nurdamiron/rams-projects/firmware/PRODUCTION_v3.2_FINAL/README.md

# RAMS Production Firmware v3.2 FINAL

**Дата:** 2026-02-15
**Статус:** ✅ ПРОТЕСТИРОВАНО И ПРОШИТО
**Автор:** RAMS Global Team

---

## 📦 Состав папки

```
PRODUCTION_v3.2_FINAL/
├── esp32/
│   ├── rams_controller_v3.ino    - ESP32 главный контроллер
│   └── ACTUATOR_CONFIG.h         - Конфигурация блоков
├── mega1/
│   ├── actuator_mega1_v3.ino     - Arduino Mega #1 (блоки 1-8)
│   └── ACTUATOR_CONFIG.h         - Конфигурация блоков
├── mega2/
│   └── actuator_mega2_v3.ino     - Arduino Mega #2 (блоки 9-15)
├── shared/
│   └── ACTUATOR_CONFIG.h         - Общая конфигурация
└── README.md                      - Этот файл
```

---

## 🎯 Назначение устройств

### ESP32 (rams_controller_v3.ino)
- **Функция:** Главный контроллер системы
- **Управление:** 15 актуаторных блоков + LED зоны
- **WiFi AP:** RAMS_Controller (пароль: rams2026)
- **Web интерфейс:** http://192.168.4.1
- **Serial порты:**
  - Serial1 (GPIO25 TX, GPIO26 RX) → Mega #1
  - Serial2 (GPIO16 TX, GPIO17 RX) → Mega #2
- **LED пины:** GPIO 21,22,23,15,13,27,32,33,5,2 (10 лент)
- **Размер:** 847 KB (64% flash)

### Arduino Mega #1 (actuator_mega1_v3.ino)
- **Функция:** Управление блоками 1-8
- **Актуаторы:** 16 штук (8 блоков × 2 актуатора)
- **Serial порт:** Serial1 (TX1/RX1 pins 18/19) → ESP32
- **Пины:** 22-53 (см. ACTUATOR_CONFIG.h)
- **Размер:** 8932 bytes (3% flash)

### Arduino Mega #2 (actuator_mega2_v3.ino)
- **Функция:** Управление блоками 9-15
- **Актуаторы:** 15 штук (6 блоков × 2 + блок 15 × 3)
- **Serial порт:** Serial1 (TX1/RX1 pins 18/19) → ESP32
- **Пины:** 22-53 (см. ACTUATOR_CONFIG.h)
- **Особенность:** Блок 15 имеет 3 актуатора!

---

## 🔌 LED Маппинг (ESP32)

### Физическая конфигурация:
- **8 лучей:** 33 LED каждый (GPIO 21,22,23,15,13,27,32,33)
- **Внутренний круг:** 64 LED (GPIO 5)
- **Внешний круг:** 150 LED (GPIO 2)

### Логика блоков:

**ВНЕШНИЕ блоки (1,3,5,7,9,11,13):**
- Внешняя часть лучей (LED 18-32)
- Внешний круг

**ВНУТРЕННИЕ блоки (2,4,6,8,10,12,14):**
- Внутренняя часть лучей (LED 0-17)
- Внутренний круг

**Блок 15 (особый):**
- ПОЛНЫЙ луч (LED 0-32)
- Внутренний круг
- БЕЗ внешнего круга

### Деление на доли:
```
Блоки 1-2   → Доля 0 (лучи GPIO21-22)
Блоки 3-4   → Доля 1 (лучи GPIO22-23)
Блоки 5-6   → Доля 2 (лучи GPIO23-15)
Блоки 7-8   → Доля 3 (лучи GPIO15-13)
Блоки 9-10  → Доля 4 (лучи GPIO13-27)
Блоки 11-12 → Доля 5 (лучи GPIO27-32)
Блоки 13-14 → Доля 6 (лучи GPIO32-33)
Блок 15     → Доля 7 (лучи GPIO33-21)
```

---

## 📡 Протокол связи (текстовый)

### Формат команд (ESP32 → Mega):
```
BLOCK:5:UP:10000    - Блок 5 вверх на 10 сек
BLOCK:3:DOWN:5000   - Блок 3 вниз на 5 сек
BLOCK:7:STOP        - Остановить блок 7
ALL:STOP            - Остановить все блоки
PING                - Проверка связи
```

### Ответы (Mega → ESP32):
```
ACK:5:UP            - Подтверждение команды
DONE:5              - Блок завершил работу
PONG                - Ответ на пинг
ERROR:message       - Ошибка
```

### Технические параметры:
- **Baud rate:** 115200
- **Формат:** 8N1
- **Heartbeat:** каждые 2 секунды
- **Timeout:** автоматическая остановка после времени

---

## 🔧 Инструкция по прошивке

### ESP32:
```bash
cd esp32/
arduino-cli compile --fqbn esp32:esp32:esp32 rams_controller_v3.ino
arduino-cli upload -p /dev/cu.usbserial-0001 --fqbn esp32:esp32:esp32 rams_controller_v3.ino
```

### Arduino Mega #1:
```bash
cd mega1/
arduino-cli compile --fqbn arduino:avr:mega actuator_mega1_v3.ino
arduino-cli upload -p /dev/cu.usbmodem141021 --fqbn arduino:avr:mega actuator_mega1_v3.ino
```

### Arduino Mega #2:
```bash
cd mega2/
# Сначала скопировать ACTUATOR_CONFIG.h из shared/
cp ../shared/ACTUATOR_CONFIG.h .
# Изменить include в .ino файле на: #include "ACTUATOR_CONFIG.h"
arduino-cli compile --fqbn arduino:avr:mega actuator_mega2_v3.ino
arduino-cli upload -p /dev/cu.usbserial-XXXX --fqbn arduino:avr:mega actuator_mega2_v3.ino
```

---

## 🎮 Web API (ESP32)

### Endpoints:

**GET /** - Главная страница с управлением

**GET /api/status** - Статус системы
```json
{
  "active": 2,
  "blocks": [1, 5]
}
```

**POST /api/block** - Управление блоком
```
?num=5&action=UP&duration=10000
```

**POST /api/stop** - Остановить все блоки

---

## ⚙️ Конфигурация пинов (ACTUATOR_CONFIG.h)

### Блок 1-8 (Mega #1):
| Блок | Акт.1 UP | Акт.1 DOWN | Акт.2 UP | Акт.2 DOWN |
|---|---|---|---|---|
| 1 | 22 | 23 | 24 | 25 |
| 2 | 26 | 27 | 28 | 29 |
| 3 | 30 | 31 | 32 | 33 |
| 4 | 34 | 35 | 36 | 37 |
| 5 | 38 | 39 | 40 | 41 |
| 6 | 50 | 51 | 52 | 53 |
| 7 | 42 | 43 | 44 | 45 |
| 8 | 46 | 47 | 48 | 49 |

### Блок 9-15 (Mega #2):
| Блок | Акт.1 UP | Акт.1 DOWN | Акт.2 UP | Акт.2 DOWN | Акт.3 UP | Акт.3 DOWN |
|---|---|---|---|---|---|---|
| 9 | 22 | 23 | 24 | 25 | - | - |
| 10 | 26 | 27 | 28 | 29 | - | - |
| 11 | 30 | 31 | 32 | 33 | - | - |
| 12 | 34 | 35 | 36 | 37 | - | - |
| 13 | 38 | 39 | 40 | 41 | - | - |
| 14 | 50 | 51 | 52 | 53 | - | - |
| 15 | 42 | 43 | 44 | 45 | 46 | 47 |

### Логика реле:
- **RELAY_ON = LOW** (инверсная логика!)
- **RELAY_OFF = HIGH**

---

## ✅ История изменений

### v3.2 (2026-02-15) - FINAL
- ✅ Правильный LED маппинг для всех 15 блоков
- ✅ OUTER блоки (1,3,5,7,9,11,13,15): внешняя часть + внешний круг
- ✅ INNER блоки (2,4,6,8,10,12,14): внутренняя часть + внутренний круг
- ✅ Блок 15: полный луч + внутренний круг, БЕЗ внешнего
- ✅ DroneControl style код (все в loop, без лишних функций)
- ✅ Текстовый протокол (быстрый sscanf парсинг)
- ✅ Централизованная конфигурация ACTUATOR_CONFIG.h
- ✅ Успешно прошито и протестировано

---

## 🚀 Быстрый старт

1. Прошить все 3 устройства (см. инструкцию выше)
2. Подключить Serial кабели: ESP32 ↔ Mega #1, ESP32 ↔ Mega #2
3. Подключить LED ленты к ESP32 (GPIO 21,22,23,15,13,27,32,33,5,2)
4. Подключить актуаторы к Mega платам (см. таблицу пинов)
5. Подключиться к WiFi "RAMS_Controller" (пароль: rams2026)
6. Открыть http://192.168.4.1
7. Тестировать блоки через веб-интерфейс

---

## 📝 Примечания

- Максимум 2 активных блока одновременно (защита от перегрузки)
- Автоматический timeout для всех операций
- Heartbeat проверка связи каждые 2 секунды
- Все настройки в одном файле ACTUATOR_CONFIG.h

---

**🎉 PRODUCTION READY!**
