nurdamiron/rams-projects/firmware/arduino_mega/README.md

# Arduino Mega - Actuator Controller

## 📋 Обзор

**ДВЕ ARDUINO MEGA** для управления 15 блоками актуаторов (31 актуатор)

- **Mega #1**: Блоки 1-8 (16 актуаторов)
- **Mega #2**: Блоки 9-15 (15 актуаторов, блок 15 имеет 3 актуатора)

Обе платы получают команды от ESP32 по Serial1.

---

## 🔌 MEGA #1 - Блоки 1-8

### Конфигурация (16 актуаторов, 32 пина)

| Блок | Пины | Актуаторы |
|---|---|---|
| 1 | 22, 23, 24, 25| 2 |
| 2 | 26, 27, 28, 29| 2 |
| 3 | 30, 31, 32, 33| 2 |
| 4 | 34, 35, 36, 37| 2 |
| 5 | 38, 39, 40, 41| 2 |
| 6 | 50, 51, 52, 53| 2 (физически запаян)|
| 7 | 42, 43, 44, 45| 2 |
| 8 | 46, 47, 48, 49| 2 |

**Прошивка:** `actuator_mega1/actuator_mega1.ino`

---

## 🔌 MEGA #2 - Блоки 9-15

### Конфигурация (15 актуаторов, 30 пинов)

| Блок | Пины | Актуаторы |
|---|---|---|
| 9 | 22, 23, 24, 25 | 2 |
| 10 | 26, 27, 28, 29 | 2 |
| 11 | 30, 31, 32, 33 | 2 |
| 12 | 34, 35, 36, 37 | 2 |
| 13 | 38, 39, 40, 41 | 2 |
| 14 | 50, 51, 52, 53 | 2 (физически запаян)|
| 15 | 42, 43, 44, 45, 46, 47 | **3** |

**ВАЖНО:** Блок 15 использует **6 пинов** для 3-х актуаторов!

**Прошивка:** `actuator_mega2/actuator_mega2.ino`

---

## 🔧 Логика работы

### Инверсная логика
- **LOW (0V)** = Актуатор включен
- **HIGH (5V)** = Актуатор выключен

### Управление одним актуатором
Каждый актуатор использует 2 пина:
- **Pin A = LOW, Pin B = HIGH** → Движение ВВЕРХ
- **Pin A = HIGH, Pin B = LOW** → Движение ВНИЗ
- **Pin A = HIGH, Pin B = HIGH** → СТОП

---

## 📡 Протокол связи

### Serial1 (TX1=18, RX1=19) ↔ ESP32

**Формат команды (JSON):**
```json
{"block":1,"action":"up","duration":12000}
{"block":9,"action":"down","duration":12000}
{"block":15,"action":"up","duration":12000}
{"block":0,"action":"stop"}
```

**Параметры:**
- `block` - номер блока:
  - Mega #1: 1-8
  - Mega #2: 9-15
  - 0 = остановить все блоки на текущей плате
- `action` - действие: "up", "down", "stop"
- `duration` - время движения в миллисекундах (по умолчанию 12000)

**Формат ответа:**
```json
{"status":"ok","block":1,"action":"up"}
{"status":"error","message":"Invalid command"}
{"status":"stopped","block":1,"reason":"timeout"}
{"status":"ready","mega":1,"blocks":8}
{"status":"ready","mega":2,"blocks":7}
```

---

## 🚀 Загрузка прошивки

### Mega #1 (Блоки 1-8)

1. **Подключи Mega #1 к USB**
2. **Открой Arduino IDE**
3. **Открой файл:** `actuator_mega1/actuator_mega1.ino`
4. **Установи библиотеку:** ArduinoJson
   - Tools → Manage Libraries → Найти "ArduinoJson" → Install
5. **Выбери настройки:**
   - Tools → Board → **Arduino Mega or Mega 2560**
   - Tools → Port → **(выбери COM порт)**
6. **Upload (Ctrl+U)**

### Mega #2 (Блоки 9-15)

1. **Подключи Mega #2 к USB**
2. **Открой Arduino IDE**
3. **Открой файл:** `actuator_mega2/actuator_mega2.ino`
4. **Установи библиотеку:** ArduinoJson (если еще не установлена)
5. **Выбери настройки:**
   - Tools → Board → **Arduino Mega or Mega 2560**
   - Tools → Port → **(выбери COM порт)**
6. **Upload (Ctrl+U)**

---

## 🧪 Тестирование

### Тест Mega #1 (через Serial Monitor, 115200 baud)

```json
{"block":1,"action":"up","duration":5000}
{"block":8,"action":"down","duration":5000}
```

**Вывод:**
```
[BLOCK 1] → UP (5000ms, 2 actuators)
[AUTO-STOP] Block 1
```

### Тест Mega #2 (через Serial Monitor, 115200 baud)

```json
{"block":9,"action":"up","duration":5000}
{"block":15,"action":"up","duration":5000}
```

**Вывод:**
```
[BLOCK 9] → UP (5000ms, 2 actuators)
[BLOCK 15] → UP (5000ms, 3 actuators)
[AUTO-STOP] Block 15
```

---

## ⚙️ Особенности

### ✅ Автоостановка
- Каждый блок автоматически останавливается после `duration` миллисекунд
- Безопасность: актуаторы не будут работать бесконечно

### ✅ Независимое управление
- Каждая Mega работает независимо
- Можно управлять несколькими блоками одновременно на одной плате
- Каждый блок имеет независимый таймер

### ✅ Обработка ошибок
- Проверка валидности JSON
- Проверка диапазона блоков
- Mega #1: блоки 1-8
- Mega #2: блоки 9-15
- Отправка статуса выполнения ESP32

---

## 🔌 Подключение к ESP32

```
Arduino Mega #1        ESP32
─────────────────────────────
TX1 (Pin 18) ────────► GPIO 16 (RX2)
RX1 (Pin 19) ◄──────── GPIO 17 (TX2)
GND ──────────────────── GND

Arduino Mega #2        ESP32
─────────────────────────────
TX1 (Pin 18) ────────► GPIO 26 (RX1)
RX1 (Pin 19) ◄──────── GPIO 25 (TX1)
GND ──────────────────── GND
```

**ESP32 использует:**
- **Serial2** (GPIO 16/17) для Mega #1
- **Serial1** (GPIO 25/26) для Mega #2

---

## 📊 Статистика

### Mega #1
- **Блоки:** 8
- **Актуаторы:** 16 (все стандартные по 2)
- **Пины:** 32 (22-53)
- **Baud rate:** 115200
- **Время по умолчанию:** 12000 мс (12 секунд)

### Mega #2
- **Блоки:** 7
- **Актуаторы:** 15 (6×2 + 1×3)
- **Пины:** 30 (22-47, 50-53)
- **Baud rate:** 115200
- **Время по умолчанию:** 12000 мс (12 секунд)

### Итого
- **Всего блоков:** 15
- **Всего актуаторов:** 31
- **Две Arduino Mega 2560**

---

## 📝 Примечания

1. **Не используй пины 0 и 1** - они зарезервированы для Serial (USB)
2. **Пины 18 и 19** используются для Serial1 (связь с ESP32)
3. **Блок 6 на Mega #1** и **Блок 14 на Mega #2** физически запаяны на пины 50-53
4. **Блок 15** имеет 3 актуатора (пины 42-47)
5. **Пины 48-49** не используются на Mega #2

---

## ⚠️ Важно

- **Mega #1** отвечает только за блоки 1-8
- **Mega #2** отвечает только за блоки 9-15
- Команды с неправильным номером блока будут отклонены
- ESP32 должен знать, на какую Mega отправлять команду для каждого блока
- Блок 15 имеет **3 актуатора** (6 пинов: 42, 43, 44, 45, 46, 47)

---

**Версия:** 2.0 (две независимые Mega)
**Дата:** 2026-02-09
