nurdamiron/rams-projects/docs/HARDWARE-ARCHITECTURE.md

# Архитектура управления хардвером RAMS Interactive Hub

## Обзор системы

Система управления хардвером для интерактивных макетов недвижимости RAMS Global. Управление освещением проектов (WS2812B LED), актуаторами (подъемники, крыши) и другими элементами через ESP32 по WiFi.

---

## Компоненты системы

### 1. **Electron/Next.js приложение** (Frontend/Backend)
- **Роль**: Интерфейс управления, отправка команд на ESP32
- **Технологии**: Next.js, React, Electron, SerialPort, WiFi HTTP
- **Расположение**: `/lib/hardware/wifi.ts`, `/lib/hardware/serial.ts`

### 2. **ESP32 микроконтроллер**
- **Роль**: Центральный контроллер хардвера
- **Функции**:
  - Получение команд по WiFi (HTTP Server)
  - Управление WS2812B LED лентами
  - Управление реле для 12В актуаторов
  - Обработка состояний и эффектов
- **WiFi**: Access Point или Station mode
- **IP**: Статический (по умолчанию 192.168.1.100)

### 3. **WS2812B адресные LED ленты**
- **Роль**: Подсветка макетов проектов
- **Характеристики**:
  - Напряжение: 5V
  - Тип данных: 1-wire protocol
  - Управление: FastLED библиотека
- **Подключение**: GPIO pin → Data line

### 4. **Реле модули** (для 12В нагрузки)
- **Роль**: Коммутация мощных 12В устройств
- **Типы**:
  - Одноканальные реле (освещение)
  - Двухканальные реле (актуаторы вверх/вниз)
- **Подключение**: GPIO → Relay IN pin

### 5. **12В Актуаторы** (Linear Actuators)
- **Роль**: Механическое перемещение элементов макета (крыши, лифты)
- **Управление**: H-Bridge или реле для изменения полярности
- **Питание**: Внешний 12В источник питания

---

## Архитектура коммуникации

```
┌─────────────────────────────────────────┐
│   Electron + Next.js Application       │
│   (Windows/Mac)                        │
│                                        │
│   WiFiHardwareService                  │
│   - sendCommand()                       │
│   - ping()                              │
└───────────────┬────────────────────────┘
                │
                │ HTTP POST /command
                │ WiFi (192.168.1.x)
                │
┌───────────────▼────────────────────────┐
│           ESP32                        │
│   Web Server (AsyncWebServer)          │
│   - Handle /command endpoint           │
│   - Parse JSON commands                │
│   - Route to hardware controllers      │
│                                        │
│   ┌─────────────────────────────────┐ │
│   │  LED Controller (FastLED)       │ │
│   │  - Project lighting effects     │ │
│   │  - Animations (fade, pulse)     │ │
│   └───────────┬─────────────────────┘ │
│               │                        │
│   ┌───────────▼─────────────────────┐ │
│   │  Relay Controller               │ │
│   │  - On/Off control               │ │
│   └───────────┬─────────────────────┘ │
│               │                        │
│   ┌───────────▼─────────────────────┐ │
│   │  Actuator Controller            │ │
│   │  - Up/Down movement             │ │
│   │  - Position tracking            │ │
│   └───────────┬─────────────────────┘ │
└───────────────┼────────────────────────┘
                │
    ┌───────────┼───────────┬──────────┐
    │           │           │          │
┌───▼───┐  ┌───▼───┐  ┌───▼────┐ ┌──▼──┐
│WS2812B│  │ Relay │  │Actuator│ │Relay│
│Strip 1│  │ #1    │  │  12V   │ │ #2  │
└───────┘  └───────┘  └────────┘ └─────┘
```

---

## Протокол команд

### Структура команды (JSON)

```typescript
interface HardwareCommand {
  action: 'select_project' | 'reset' | 'screensaver' |
          'toggle_element' | 'highlight' | 'off' | 'actuator';
  projectId?: number;        // ID проекта (0-27)
  target?: string;           // Целевой элемент (light, roof, landscape)
  state?: 'up' | 'down' | boolean;  // Состояние
  data?: {
    brightness?: number;     // Яркость (0-255)
    color?: string;          // Hex цвет (#FF0000)
    effect?: string;         // Эффект (fade, pulse, rainbow)
    duration?: number;       // Длительность в мс
  };
}
```

### Примеры команд

#### 1. Подсветить проект
```json
{
  "action": "highlight",
  "projectId": 9,
  "data": {
    "brightness": 200,
    "color": "#FFD700",
    "effect": "fade"
  }
}
```

#### 2. Управление актуатором
```json
{
  "action": "actuator",
  "target": "roof",
  "state": "up"
}
```

#### 3. Сброс всего
```json
{
  "action": "reset"
}
```

---

## Конфигурация проектов

Каждый проект имеет `hardwareId` для связи с физическим макетом:

```typescript
// lib/data/projects.ts
export interface Project {
  id: string;
  name: string;
  hardwareId?: number;  // Физический ID на контроллере (0-27)
  // ...
}
```

### Маппинг проектов на хардвер

| projectId | Название проекта | LED Start | LED Count | Реле | Актуатор |
|---|---|---|---|---|---|
| 0 | RAMS BEYOND | 0 | 50 | - | - |
| 1 | RAMS CITY | 50 | 30 | 1 | - |
| 2 | NOMAD | 80 | 20 | - | - |
| 9 | RAMS GARDEN | 200 | 60 | 2 | 1 |
| 11 | RAMS SIGNATURE | 300 | 50 | 3 | 2 |
| ... | ... | ... | ... | ...  | ... |

---

## Состояния и логика

### 1. **Режимы работы**

#### Idle Mode (Ожидание)
- Все проекты выключены
- Screensaver может быть активен (плавная анимация)

#### Project Highlight Mode
- Один проект подсвечен
- Остальные затемнены или выключены
- Возможные эффекты: fade in, pulse, rainbow

#### Demo Mode (Screensaver)
- Циклическая подсветка проектов
- Rainbow или wave эффект по всем LED

### 2. **Debouncing и очередь команд**

Реализовано в `WiFiHardwareService`:
- Команды дебаунсятся на 150ms
- При быстром переключении отменяется предыдущая команда
- Команды актуаторов выполняются немедленно

---

## Технические спецификации

### ESP32 Pinout

| Функция | GPIO Pin | Тип | Примечание |
|---|---|---|---|
| WS2812B Data | GPIO 16  | Output  | 5V logic, level shifter |
| Relay 1 | GPIO 17  | Output  | Активный LOW |
| Relay 2 | GPIO 18  | Output  | Активный LOW |
| Relay 3 | GPIO 19  | Output  | Активный LOW |
| Actuator Up | GPIO 21  | Output  | Через H-Bridge или реле |
| Actuator Down | GPIO 22  | Output  | Через H-Bridge или реле |
| Status LED | GPIO 2 | Output  | Встроенный LED |
| Button (optional) | GPIO 0 | Input | Pullup, для тестирования |

### Питание

1. **ESP32**: 5V от USB или DC-DC converter
2. **WS2812B**: 5V, ток зависит от количества LED (50mA на LED при полной яркости)
   - 100 LED × 50mA = 5A @ 5V
   - **Рекомендуется**: Отдельный БП 5V/10A
3. **Реле**: 5V логика, коммутируют 12V нагрузку
4. **Актуаторы**: 12V, ток зависит от модели (обычно 2-5A)
   - **Рекомендуется**: Отдельный БП 12V/10A

### Безопасность

- **Оптоизоляция**: Реле модули имеют встроенную оптопару
- **Защита**: Диоды обратной полярности на актуаторах
- **Предохранители**: На каждой 12V линии
- **WiFi**: WPA2 шифрование, статический IP

---

## Библиотеки для ESP32

### Arduino IDE / PlatformIO

```ini
[platformio]
platform = espressif32
framework = arduino

[env:esp32dev]
board = esp32dev
lib_deps =
    fastled/FastLED @ ^3.6.0
    me-no-dev/ESPAsyncWebServer @ ^1.2.3
    me-no-dev/AsyncTCP @ ^1.1.1
    bblanchon/ArduinoJson @ ^6.21.0
```

### Ключевые библиотеки

1. **FastLED**: Управление WS2812B
2. **ESPAsyncWebServer**: HTTP сервер
3. **ArduinoJson**: Парсинг JSON команд
4. **WiFi**: Встроенная библиотека ESP32

---

## Эффекты и анимации

### Доступные эффекты

1. **Fade In/Out**: Плавное включение/выключение
2. **Pulse**: Пульсация яркости
3. **Rainbow**: Радужный эффект
4. **Wave**: Волна света
5. **Sparkle**: Мерцание
6. **Chase**: Бегущий огонь

### Реализация эффектов

```cpp
void fadeIn(int projectId, CRGB color, int duration) {
  int startLed = projects[projectId].ledStart;
  int count = projects[projectId].ledCount;

  for (int brightness = 0; brightness <= 255; brightness += 5) {
    for (int i = 0; i < count; i++) {
      leds[startLed + i] = color;
      leds[startLed + i].fadeLightBy(255 - brightness);
    }
    FastLED.show();
    delay(duration / 51);  // 51 steps (0-255 by 5)
  }
}
```

---

## Диагностика и отладка

### Индикация статуса

- **Встроенный LED (GPIO 2)**:
  - Быстрое мигание: Подключение к WiFi
  - Медленное мигание: Ожидание команд
  - Постоянно горит: Выполнение команды

### Serial Monitor

```cpp
Serial.begin(115200);
Serial.println("[INFO] ESP32 Hardware Controller Started");
Serial.print("[WIFI] IP Address: ");
Serial.println(WiFi.localIP());
```

### Логи на клиенте

```typescript
console.log('[Hardware WiFi] Command sent:', command.action);
console.warn('[Hardware WiFi] Hardware not available');
```

---

## Масштабируемость

### Для больших установок

1. **Множественные ESP32**:
   - Каждый ESP32 управляет своей группой проектов
   - Разные IP адреса (192.168.1.100, 192.168.1.101, ...)
   - Клиент рутит команды на нужный контроллер

2. **MQTT брокер** (опционально):
   - Централизованная система сообщений
   - Лучше для 10+ контроллеров
   - Pub/Sub архитектура

3. **Большие LED массивы**:
   - Параллельные линии (FastLED поддерживает до 8 параллельных)
   - Внешний драйвер питания для каждых 100-200 LED

---

## Troubleshooting

### ESP32 не отвечает

1. Проверить WiFi соединение
2. Ping ESP32: `ping 192.168.1.100`
3. Проверить Serial Monitor на ошибки
4. Перезагрузить ESP32

### LED не работают

1. Проверить питание 5V
2. Проверить Data line подключение
3. Уменьшить яркость (перегрев/недостаточный ток)
4. Добавить резистор 470Ω на Data line

### Актуаторы не двигаются

1. Проверить 12V питание
2. Проверить реле срабатывание (должен быть слышен щелчок)
3. Измерить напряжение на выходе реле
4. Проверить предохранители

### Команды выполняются медленно

1. Уменьшить COMMAND_DEBOUNCE_MS
2. Проверить WiFi сигнал
3. Оптимизировать эффекты (меньше delay)

---

## Следующие шаги

1. ✅ Архитектура определена
2. 🔄 Написание прошивки ESP32
3. 🔄 Схема подключения
4. 🔄 Конфигурация проектов
5. 🔄 Тестирование и калибровка

---

## Контакты

- **Документация**: `/docs/`
- **Исходники клиента**: `/lib/hardware/`
- **Firmware ESP32**: `/firmware/esp32/`

---

**Дата создания**: 2026-01-27
**Версия**: 1.0
**Автор**: RAMS Interactive Hub Team
