nurdamiron/rams-projects/firmware/ESP32-MEGA-COMMUNICATION.md

# 📡 ESP32 ↔ Arduino Mega Communication

## Архитектура системы

```
┌──────────────────────────────────────────────┐
│         Next.js Application                  │
│         (Touch Screen UI)                    │
└────────────────┬─────────────────────────────┘
                 │ WiFi HTTP
                 │ POST /command
                 ▼
┌──────────────────────────────────────────────┐
│              ESP32                           │
│      Master Controller v1.0                  │
│  • Принимает HTTP команды от Next.js         │
│  • Управляет LED WS2812B                     │
│  • Отправляет команды на Mega через Serial   │
└────────────┬─────────────────────────────────┘
             │ Serial UART (115200 baud)
             │ GPIO16(RX) ← TX1 Mega
             │ GPIO17(TX) → RX1 Mega
             ▼
┌──────────────────────────────────────────────┐
│         Arduino Mega #1                      │
│    Actuator Controller v1.0                  │
│  • Принимает JSON команды через Serial1      │
│  • Управляет 8 блоками (16 актуаторов)      │
│  • Автоостановка по таймеру                  │
│  • Отправляет подтверждения ESP32           │
└──────────────────────────────────────────────┘
```

---

## 🔌 Подключение

### Схема соединений

```
ESP32                    Arduino Mega
─────────────────────────────────────────
GPIO 17 (TX2) ────────► RX1 (Pin 19)
GPIO 16 (RX2) ◄──────── TX1 (Pin 18)
GND ──────────────────── GND
```

**ВАЖНО:**
- Общая земля (GND) обязательна!
- ESP32 работает на 3.3V, Mega на 5V
- Обычно совместимы напрямую, но для надёжности можно использовать level shifter

---

## 📋 Протокол связи

### Формат команды (ESP32 → Mega)

```json
{
  "block": 1,           // Номер блока (1-8), 0 = все блоки
  "action": "up",       // Действие: "up", "down", "stop"
  "duration": 12000     // Длительность движения (мс)
}
```

### Формат ответа (Mega → ESP32)

```json
{
  "status": "ok",       // Статус: "ok", "error", "stopped"
  "block": 1,           // Номер блока
  "action": "up",       // Выполненное действие
  "message": "..."      // Опциональное сообщение (при ошибке)
}
```

---

## 🎯 Примеры использования

### 1. Frontend → ESP32 (WiFi HTTP)

```typescript
// В Next.js приложении
import { hardwareService } from '@/lib/hardware-service';

// Поднять блок #1 на 12 секунд
await hardwareService.sendCommand({
  action: 'actuator',
  target: 'block_1',
  state: 'up',
  data: {
    duration: 12000
  }
});

// Опустить блок #3 на 10 секунд
await hardwareService.sendCommand({
  action: 'actuator',
  target: 'block_3',
  state: 'down',
  data: {
    duration: 10000
  }
});

// Остановить блок #5
await hardwareService.sendCommand({
  action: 'actuator',
  target: 'block_5',
  state: 'stop'
});

// Остановить ВСЕ блоки
await hardwareService.sendCommand({
  action: 'actuator',
  target: 'block_0',
  state: 'stop'
});
```

### 2. ESP32 → Arduino Mega (Serial)

```cpp
// В ESP32 коде (автоматически вызывается из executeCommand)
// Поднять блок #1
sendToMega(1, "up", 12000);

// Опустить блок #3
sendToMega(3, "down", 12000);

// Остановить блок #5
sendToMega(5, "stop", 0);

// Остановить все блоки
sendToMega(0, "stop", 0);
```

### 3. Прямая отправка команды на Mega (через Serial Monitor)

```json
{"block":1,"action":"up","duration":12000}
{"block":2,"action":"down","duration":10000}
{"block":5,"action":"stop"}
{"block":0,"action":"stop"}
```

---

## 🧪 Тестирование системы

### Шаг 1: Загрузка прошивок

#### Arduino Mega
```bash
cd /Users/nurdauletakhmatov/Desktop/rams-screen/rams-interactive-hub/firmware/arduino_mega/actuator_test
# Открыть actuator_test.ino в Arduino IDE
# Выбрать: Tools → Board → Arduino Mega
# Выбрать правильный COM порт
# Upload (Ctrl+U)
```

#### ESP32
```bash
cd /Users/nurdauletakhmatov/Desktop/rams-screen/rams-interactive-hub/firmware/esp32/rams_controller
# Открыть rams_controller.ino в Arduino IDE
# Выбрать: Tools → Board → ESP32 Dev Module
# Upload
```

### Шаг 2: Проверка Serial связи

1. **Подключить USB к Mega** → Открыть Serial Monitor (115200 baud)
   ```
   [READY] Waiting for commands from ESP32...
   ```

2. **Отправить тестовую команду** через Serial Monitor:
   ```json
   {"block":1,"action":"up","duration":5000}
   ```

3. **Проверить вывод:**
   ```
   [CMD] Received: {"block":1,"action":"up","duration":5000}
   [BLOCK 1] → UP (5000ms)
   ```

4. **Через 5 секунд:**
   ```
   [AUTO-STOP] Block 1
   ```

### Шаг 3: Проверка ESP32 → Mega

1. **Подключить ESP32 к WiFi**
   - Проверить IP: `http://192.168.1.100/status`

2. **Отправить команду через WiFi:**
   ```bash
   curl -X POST http://192.168.1.100/command \
     -H "Content-Type: application/json" \
     -d '{
       "action": "actuator",
       "target": "block_1",
       "state": "up",
       "data": {"duration": 5000}
     }'
   ```

3. **Проверить логи ESP32** (Serial Monitor):
   ```
   [CMD] Action: actuator | Target: block_1
   [MEGA] Sent: {"block":1,"action":"up","duration":5000}
   [MEGA] Response: {"status":"ok","block":1,"action":"up"}
   ```

4. **Проверить логи Mega**:
   ```
   [CMD] Received: {"block":1,"action":"up","duration":5000}
   [BLOCK 1] → UP (5000ms)
   [AUTO-STOP] Block 1
   ```

### Шаг 4: Проверка из Next.js приложения

```typescript
// В любом React компоненте
const handleBlockUp = async () => {
  const result = await hardwareService.sendCommand({
    action: 'actuator',
    target: 'block_1',
    state: 'up',
    data: { duration: 12000 }
  });

  console.log('Result:', result);
};
```

---

## 🔧 Troubleshooting

### Проблема: Mega не получает команды от ESP32

1. **Проверить подключение:**
   - ESP32 TX (GPIO17) → Mega RX1 (Pin 19)
   - ESP32 RX (GPIO16) → Mega TX1 (Pin 18)
   - Общая земля (GND)

2. **Проверить Serial Monitor Mega:**
   - Должно быть сообщение `[INIT] Serial1 ready for ESP32 commands`

3. **Проверить ESP32 Serial Monitor:**
   - Должно быть сообщение `[SETUP] Mega serial initialized on GPIO16(RX)/GPIO17(TX) ✓`

4. **Проверить baud rate:**
   - Оба должны быть 115200

### Проблема: Актуаторы не двигаются

1. **Проверить пины в Arduino Mega:**
   - Блок 1: пины 22, 23, 24, 25
   - Блок 2: пины 26, 27, 28, 29
   - и т.д.

2. **Проверить логику:**
   - ИНВЕРСНАЯ ЛОГИКА: LOW = включено, HIGH = выключено

3. **Проверить питание:**
   - Актуаторы требуют 12V
   - Достаточно ли ампер?

### Проблема: ESP32 не отправляет команды

1. **Проверить WiFi соединение:**
   ```bash
   curl http://192.168.1.100/ping
   ```

2. **Проверить формат target:**
   - Должен начинаться с `block_` (например `block_1`, `block_3`)

3. **Проверить Serial Monitor ESP32:**
   - Должны быть сообщения `[MEGA] Sent: ...`

---

## 📊 Маппинг блоков на пины

| Блок | Актуаторы | Pin 1 | Pin 2 | Pin 3 | Pin 4 |
|---|---|---|---|---|---|
| 1 | 2 шт | 22 | 23 | 24 | 25 |
| 2 | 2 шт | 26 | 27 | 28 | 29 |
| 3 | 2 шт | 30 | 31 | 32 | 33 |
| 4 | 2 шт | 34 | 35 | 36 | 37 |
| 5 | 2 шт | 38 | 39 | 40 | 41 |
| 6 | 2 шт | 50 | 51 | 52 | 53 |
| 7 | 2 шт | 42 | 43 | 44 | 45 |
| 8 | 2 шт | 46 | 47 | 48 | 49 |

**Логика управления одним блоком:**
- Pin 1 (LOW) + Pin 2 (HIGH) = Актуатор 1 ВВЕРХ
- Pin 1 (HIGH) + Pin 2 (LOW) = Актуатор 1 ВНИЗ
- Pin 3 (LOW) + Pin 4 (HIGH) = Актуатор 2 ВВЕРХ
- Pin 3 (HIGH) + Pin 4 (LOW) = Актуатор 2 ВНИЗ
- Все HIGH = СТОП

---

## 🚀 Готовые команды для тестирования

### Через curl (WiFi)

```bash
# Поднять блок 1 на 12 секунд
curl -X POST http://192.168.1.100/command \
  -H "Content-Type: application/json" \
  -d '{"action":"actuator","target":"block_1","state":"up","data":{"duration":12000}}'

# Опустить блок 3 на 10 секунд
curl -X POST http://192.168.1.100/command \
  -H "Content-Type: application/json" \
  -d '{"action":"actuator","target":"block_3","state":"down","data":{"duration":10000}}'

# Остановить блок 5
curl -X POST http://192.168.1.100/command \
  -H "Content-Type: application/json" \
  -d '{"action":"actuator","target":"block_5","state":"stop"}'

# Остановить ВСЕ блоки
curl -X POST http://192.168.1.100/command \
  -H "Content-Type: application/json" \
  -d '{"action":"actuator","target":"block_0","state":"stop"}'
```

### Через Serial Monitor Mega

```json
{"block":1,"action":"up","duration":12000}
{"block":2,"action":"down","duration":10000}
{"block":3,"action":"up","duration":8000}
{"block":0,"action":"stop"}
```

---

## 📝 Примечания

1. **Автоостановка**: Mega автоматически остановит актуаторы после `duration` миллисекунд
2. **Безопасность**: Если связь потеряна, Mega остановит актуаторы по таймеру
3. **Конкуренция**: Можно управлять несколькими блоками одновременно
4. **Логирование**: Все команды логируются в Serial Monitor для отладки

---

## 🎯 Следующие шаги

1. ✅ **Протестировать прямую связь Mega** (через Serial Monitor)
2. ✅ **Протестировать ESP32 → Mega** (через WiFi curl)
3. ✅ **Интегрировать в Next.js UI** (кнопки для управления блоками)
4. ⏳ **Добавить визуальные индикаторы** (показывать статус блоков)
5. ⏳ **Добавить датчики** (концевые выключатели для актуаторов)

---

**Документация обновлена:** 2026-02-08
**Версия:** 1.0
**Автор:** RAMS Global Team
