nurdamiron/rams-projects/firmware/esp32/README-START-HERE.md

# НАЧНИТЕ ОТСЮДА - RAMS Interactive Hub Hardware

## 📖 Быстрый старт

Добро пожаловать в систему управления хардвером для интерактивных макетов RAMS!

Этот гайд поможет вам подключить и настроить:
- ESP32 контроллер
- WS2812B LED ленты 12V
- Реле модули 5V/10A+
- Актуаторы 12V
- WiFi связь с Electron приложением

---

## 🎯 Что вы получите

После завершения установки:
- ✅ Интерактивный макет с подсветкой проектов
- ✅ Управление через WiFi (компьютер → ESP32)
- ✅ Эффекты: fade, pulse, rainbow, screensaver
- ✅ Управление дополнительным освещением через реле
- ✅ Управление движущимися элементами (актуаторы)

---

## 📚 Структура документации

Читать в следующем порядке:

### 1. **SHOPPING-LIST.md** - Что нужно купить
**Время**: 10 минут

- Полный список компонентов
- Где купить (AliExpress, Amazon, местные магазины)
- Примерная стоимость (~$100-200)
- Готовые наборы

👉 **Начните с этого файла**, чтобы заказать компоненты!

---

### 2. **WIRING-12V.md** - Подключение 12V оборудования
**Время**: 20 минут

- Детальные схемы подключения
- Особенности 12V WS2812B LED
- Level Shifter (3.3V → 5V)
- Питание и безопасность
- Реле и актуаторы

👉 **Прочитать перед подключением**, чтобы понять схему!

---

### 3. **LED-LAYOUT-GUIDE.md** - Схемы расположения LED
**Время**: 15 минут

- Круговой макет (радиальные секторы)
- Линейный макет (улицы/здания)
- Комбинированные схемы
- Как соединять LED ленты

👉 **Выберите схему** под ваш макет!

---

### 4. **PROJECT-CONFIG-EXAMPLE.h** - Конфигурация проектов
**Время**: 30 минут

- Пример маппинга проектов на хардвер
- Настройка GPIO пинов
- Настройка LED адресов
- Настройка реле и актуаторов

👉 **Скопируйте и адаптируйте** под ваши проекты!

---

### 5. **STEP-BY-STEP-INSTALL.md** - Пошаговая установка
**Время**: 3-5 часов

**ГЛАВНЫЙ ГАЙД!** Подробная инструкция:

- ШАГ 0: Проверка компонентов
- ШАГ 1: Подготовка ESP32
- ШАГ 2: Подключение первого LED (ТЕСТ)
- ШАГ 3: Подключение всех LED лент
- ШАГ 4: Подключение реле
- ШАГ 5: Подключение актуаторов
- ШАГ 6: Финальное тестирование

👉 **Следуйте этому гайду шаг за шагом!**

---

### 6. **HARDWARE-ARCHITECTURE.md** - Техническая архитектура
**Время**: 20 минут (опционально)

- Полная архитектура системы
- Протокол коммуникации
- API endpoints
- Эффекты и анимации
- Масштабируемость

👉 **Для понимания** как все работает изнутри.

---

### 7. **README.md** (ESP32 Firmware) - Документация прошивки
**Время**: 15 минут

- Установка Arduino IDE / PlatformIO
- Библиотеки
- API документация
- Troubleshooting
- Примеры команд

👉 **Справочник** по прошивке ESP32.

---

## 🚀 Быстрый путь (для опытных)

Если у вас уже есть опыт с ESP32 и LED лентами:

1. ✅ Купить компоненты из `SHOPPING-LIST.md`
2. ✅ Загрузить `rams_controller.ino` на ESP32
3. ✅ Подключить по схеме из `WIRING-12V.md`
4. ✅ Настроить конфигурацию в `PROJECT-CONFIG-EXAMPLE.h`
5. ✅ Протестировать через `curl` или браузер

---

## 📦 Что находится в этой папке

```
firmware/esp32/
│
├── README-START-HERE.md          ← ВЫ ЗДЕСЬ!
│
├── SHOPPING-LIST.md               ← Что купить
├── WIRING-12V.md                  ← Схемы подключения 12V
├── LED-LAYOUT-GUIDE.md            ← Схемы расположения LED
├── PROJECT-CONFIG-EXAMPLE.h       ← Пример конфигурации
├── STEP-BY-STEP-INSTALL.md        ← Пошаговая установка ⭐
│
├── rams_controller/               ← Прошивка ESP32
│   ├── rams_controller.ino        ← Основной файл
│   └── platformio.ini             ← Конфигурация PlatformIO
│
└── README.md                      ← Документация прошивки
```

---

## ⏱️ Сколько времени потребуется

### Фаза 1: Подготовка (1 день)
- Изучение документации: 2 часа
- Заказ компонентов: 30 минут
- Ожидание доставки: 1-4 недели

### Фаза 2: Установка (1 день)
- Подготовка ESP32: 1 час
- Тест первого LED: 30 минут
- Подключение всех LED: 2 часа
- Подключение реле и актуаторов: 1 час
- Тестирование: 1 час
- **ИТОГО**: ~5-6 часов

### Фаза 3: Калибровка (2-3 часа)
- Настройка яркости и цветов
- Проверка всех проектов
- Отладка проблем

**ОБЩЕЕ ВРЕМЯ**: 1-2 дня работы + время доставки компонентов

---

## 🛠️ Необходимые навыки

### Обязательно:
- ✅ Базовые знания электроники (напряжение, ток, полярность)
- ✅ Умение пользоваться мультиметром
- ✅ Умение подключать провода
- ✅ Базовые навыки работы с компьютером

### Полезно (но не обязательно):
- 🔧 Опыт с Arduino/ESP32
- 🔧 Навыки пайки
- 🔧 Программирование на C++

**Если нет опыта**: Не переживайте! Гайд написан максимально подробно, с картинками и пошаговыми инструкциями.

---

## ⚠️ Важные предупреждения

### Безопасность

1. **Электричество 220V**:
   - ⚡ ОПАСНО! Будьте осторожны с блоком питания
   - Подключайте к розетке только когда все собрано
   - Используйте БП с защитой от КЗ

2. **12V постоянный ток**:
   - ✅ Относительно безопасно
   - Но может быть БОЛЬШОЙ ТОК (10A+)
   - Избегайте короткого замыкания

3. **Полярность**:
   - ❌ Неправильная полярность = сгоревшие компоненты!
   - Всегда проверяйте: красный = +, черный = -

4. **Общая земля (GND)**:
   - ✅ КРИТИЧНО! Все GND должны быть соединены
   - ESP32 GND = БП 12V GND = общая земля

### Частые ошибки

- ❌ Забыли Level Shifter (LED не работают)
- ❌ Нет общей земли (LED мерцают или не работают)
- ❌ Неправильное направление Data line (LED не работают)
- ❌ Недостаточно мощный БП (LED тусклые)
- ❌ Неправильный тип LED (WS2811 vs WS2812B)

**Избежать**: Читайте документацию внимательно!

---

## 💡 Советы для успеха

### 1. Тестируйте поэтапно
- ✅ Не подключайте все сразу!
- ✅ Сначала ESP32
- ✅ Потом 1 метр LED
- ✅ Потом остальные LED
- ✅ Потом реле
- ✅ Потом актуаторы

### 2. Маркируйте провода
- Используйте цветную маркировку
- Наклеивайте бирки
- Делайте фото на каждом этапе

### 3. Измеряйте напряжение
- Проверяйте мультиметром перед включением
- +12V должно быть 11.8-12.3V
- 5V должно быть 4.8-5.2V

### 4. Делайте резервные копии
- Сохраните рабочую конфигурацию
- Сделайте фото проводки
- Запишите номера GPIO пинов

---

## 🆘 Помощь и поддержка

### Если что-то не работает:

1. **Проверьте Serial Monitor** ESP32:
   - Там будут логи и ошибки
   - 115200 baud rate

2. **Раздел Troubleshooting**:
   - `STEP-BY-STEP-INSTALL.md` → раздел "Troubleshooting"
   - `README.md` → раздел "Troubleshooting"

3. **Проверьте контакты**:
   - 90% проблем = плохой контакт
   - Перепроверьте все соединения

4. **Измерьте напряжение**:
   - Мультиметр - ваш лучший друг!

### Полезные ресурсы:

- **FastLED Wiki**: https://github.com/FastLED/FastLED/wiki
- **ESP32 Docs**: https://docs.espressif.com/
- **WS2812B Datasheet**: https://cdn-shop.adafruit.com/datasheets/WS2812B.pdf

---

## 📝 Чек-лист перед началом

Перед тем как начать, убедитесь что:

- [ ] Прочитали **SHOPPING-LIST.md**
- [ ] Заказали (или купили) все компоненты
- [ ] Прочитали **WIRING-12V.md** (поняли схему)
- [ ] Выбрали схему расположения LED из **LED-LAYOUT-GUIDE.md**
- [ ] Есть все инструменты (мультиметр, отвертки, кусачки)
- [ ] Есть 5-6 часов свободного времени для установки
- [ ] Готовы следовать **STEP-BY-STEP-INSTALL.md**

**Если все ✅ → Начинаем!**

---

## 🎉 После установки

Когда все заработает:

1. **Калибровка**:
   - Настроить яркость каждого проекта
   - Настроить цвета
   - Проверить эффекты

2. **Интеграция с приложением**:
   - Запустить Electron приложение
   - Проверить что команды работают
   - Настроить hardwareId в projects.ts

3. **Обучение персонала**:
   - Показать как включать/выключать
   - Объяснить базовые функции
   - Предупредить о правилах безопасности

4. **Обслуживание**:
   - Регулярно проверять контакты
   - Чистить от пыли
   - Проверять температуру компонентов

---

## 📧 Контакты

- **Проект**: RAMS Interactive Hub
- **GitHub**: https://github.com/rams-global
- **Email**: support@rams.global

---

## 📅 История версий

- **v1.0** (2026-01-27): Первый релиз документации
  - Полная архитектура
  - Прошивка ESP32
  - Пошаговые гайды
  - Поддержка 12V WS2812B

---

**Удачи с установкой! 🚀**

**Следующий шаг**: Откройте `SHOPPING-LIST.md` и начните с покупки компонентов!
