nurdamiron/rams-projects/firmware/PRODUCTION_v3.2_FINAL/PIN_MAPPING_REFERENCE.md

# RAMS ACTUATOR PIN MAPPING - ЭТАЛОННАЯ КОНФИГУРАЦИЯ

**Дата финализации:** 2026-03-04
**Версия прошивки:** v3.2_FINAL
**Статус:** ПРОТЕСТИРОВАНО И РАБОТАЕТ ✅

---

## ARDUINO MEGA #1 (Блоки 1-8)

| Блок | Актуаторы | Пины | Особенности |
|---|---|---|---|
| 1 | 2 | 22-25 | Стандарт |
| 2 | 2 | 26-29 | Стандарт |
| 3 | 2 | 30-33 | Стандарт |
| 4 | 2 | 34-37 | Стандарт |
| 5 | 2 | 38-41 | Стандарт |
| 6 | 2 | **50-53** | **Физически запаян** |
| 7 | 2 | 42-45 | Переназначен |
| 8 | 2 | 46-49 | Переназначен |

**Детальный маппинг Mega #1:**
- Блок 1: Act1(22↑,23↓) Act2(24↑,25↓)
- Блок 2: Act1(26↑,27↓) Act2(28↑,29↓)
- Блок 3: Act1(30↑,31↓) Act2(32↑,33↓)
- Блок 4: Act1(34↑,35↓) Act2(36↑,37↓)
- Блок 5: Act1(38↑,39↓) Act2(40↑,41↓)
- Блок 6: Act1(50↑,51↓) Act2(52↑,53↓) ⚠️ Физически запаян
- Блок 7: Act1(42↑,43↓) Act2(44↑,45↓)
- Блок 8: Act1(46↑,47↓) Act2(48↑,49↓)

---

## ARDUINO MEGA #2 (Блоки 9-15)

| Блок | Актуаторы | Пины | Особенности |
|---|---|---|---|
| 9 | 2 | 22-25 | Стандарт |
| 10 | 2 | 26-29 | Стандарт |
| 11 | 2 | **34-37** | **Поменян с блоком 12** ⚠️ |
| 12 | 2 | **30-33** | **Поменян с блоком 11** ⚠️ |
| 13 | 2 | 38-41 | Стандарт |
| 14 | 2 | 42-45 | Стандарт |
| 15 | **3** | **46-51** | **3 АКТУАТОРА, Act3 инвертирован** ⚠️ |

**Детальный маппинг Mega #2:**
- Блок 9:  Act1(22↑,23↓) Act2(24↑,25↓)
- Блок 10: Act1(26↑,27↓) Act2(28↑,29↓)
- Блок 11: Act1(34↑,35↓) Act2(36↑,37↓) ⚠️ Поменян с 12
- Блок 12: Act1(30↑,31↓) Act2(32↑,33↓) ⚠️ Поменян с 11
- Блок 13: Act1(38↑,39↓) Act2(40↑,41↓)
- Блок 14: Act1(42↑,43↓) Act2(44↑,45↓)
- Блок 15: Act1(46↑,47↓) Act2(48↑,49↓) Act3(51↑,50↓) ⚠️ Act3 инвертирован!

---

## КРИТИЧЕСКИЕ ОСОБЕННОСТИ

### 🔴 MEGA #2 - БЛОКИ 11 И 12 ПОМЕНЯНЫ МЕСТАМИ
Физическая проводка блоков 11 и 12 перепутана. В коде они исправлены:
- **Команда BLOCK:11** → физические пины 34-37
- **Команда BLOCK:12** → физические пины 30-33

### 🔴 MEGA #2 - БЛОК 15 АКТУАТОР 3 ИНВЕРТИРОВАН
Третий актуатор блока 15 (средний, ближе к центру) имеет обратную проводку:
- **Act3 UP:** пин 51 (не 50!)
- **Act3 DOWN:** пин 50 (не 51!)

### 🔴 ПИНЫ 52-53 НЕ ИСПОЛЬЗУЮТСЯ НА MEGA #2
На Mega #2 пины 52-53 **не подключены**. Используются только пины 22-51.

---

## ЛОГИКА РЕЛЕ

```cpp
#define RELAY_ON   LOW   // Инверсная логика: LOW = включено
#define RELAY_OFF  HIGH  // HIGH = выключено
```

Все реле используют **инверсную логику**:
- Для включения актуатора → устанавливаем пин в LOW
- Для выключения актуатора → устанавливаем пин в HIGH

---

## ПРОТОКОЛ СВЯЗИ

**Формат команды:**
```
BLOCK:<номер>:<действие>:<длительность_мс>
```

**Примеры:**
```
BLOCK:15:UP:6000      - Блок 15 вверх на 6 секунд
BLOCK:11:DOWN:10000   - Блок 11 вниз на 10 секунд
BLOCK:12:STOP         - Остановить блок 12
ALL:STOP              - Остановить все блоки
PING                  - Проверка связи
```

**Ответы:**
```
ACK:15:UP             - Подтверждение
DONE:15               - Блок завершил работу
PONG                  - Ответ на PING
ERROR:message         - Ошибка
```

---

## ФАЙЛЫ КОНФИГУРАЦИИ

**Единый источник истины:**
```
/firmware/PRODUCTION_v3.2_FINAL/shared/ACTUATOR_CONFIG.h
```

**Копии (автоматически синхронизируются):**
- `/firmware/PRODUCTION_v3.2_FINAL/actuator_mega1_v3/ACTUATOR_CONFIG.h`
- `/firmware/PRODUCTION_v3.2_FINAL/actuator_mega2_v3/ACTUATOR_CONFIG.h`
- `/firmware/PRODUCTION_v3.2_FINAL/esp32/rams_controller_v3/ACTUATOR_CONFIG.h`
- `/firmware/esp32/rams_controller_v3/ACTUATOR_CONFIG.h`

---

## ПРОШИВКИ

**Arduino Mega #1:**
```
/firmware/PRODUCTION_v3.2_FINAL/actuator_mega1_v3/actuator_mega1_v3.ino
```

**Arduino Mega #2:**
```
/firmware/PRODUCTION_v3.2_FINAL/actuator_mega2_v3/actuator_mega2_v3.ino
```

**ESP32 Master:**
```
/firmware/PRODUCTION_v3.2_FINAL/esp32/rams_controller_v3/rams_controller_v3.ino
```

---

## ИСТОРИЯ ИЗМЕНЕНИЙ

### 2026-03-04 - ФИНАЛЬНАЯ ВЕРСИЯ v3.2
- ✅ Исправлена инверсия актуатора 3 блока 15 (пины 51↑, 50↓)
- ✅ Поменяны местами блоки 11 и 12 (физическая проводка перепутана)
- ✅ Уточнено что пины 52-53 не используются на Mega #2
- ✅ Протестированы все 15 блоков
- ✅ Подтверждена корректная работа всех актуаторов

### Предыдущие проблемы (ИСПРАВЛЕНЫ):
- ❌ Блок 14: был на пинах 50-53 → исправлен на 42-45
- ❌ Блок 15: актуатор 3 был на пинах 50↑,51↓ → исправлен на 51↑,50↓
- ❌ Блоки 11-12: были на неправильных пинах → поменяны местами

---

## ТЕСТИРОВАНИЕ

**Протестировано:**
- ✅ Все 15 блоков отвечают на команды
- ✅ Направление движения UP/DOWN корректно
- ✅ Все актуаторы двигаются синхронно
- ✅ Блок 15 с 3 актуаторами работает правильно
- ✅ Таймауты и автоостановка работают
- ✅ Протокол связи стабилен

**Известные ограничения:**
- Максимум 2 блока одновременно (MAX_ACTIVE_BLOCKS = 2)
- Длительность по умолчанию: 6 секунд (DEFAULT_DURATION_MS = 6000)

---

## КОНТАКТЫ

**Проект:** RAMS Interactive Hub
**Команда:** RAMS Global Team
**Дата последнего обновления:** 2026-03-04

---

**⚠️ ВНИМАНИЕ:** Этот документ является эталонной конфигурацией. Любые изменения в маппинге пинов должны быть отражены здесь и протестированы на физическом оборудовании!
