nurdamiron/rams-projects/firmware/arduino_mega/ACTUATOR_7_PINS.md

# Actuator 7 - Вторая мега, 7 блок (последний)

## Пины
- PIN 50
- PIN 51

## Рабочая логика
**TEST 3: BOTH LOW (50=LOW, 51=LOW)** - РАБОТАЕТ! Актуатор движется

## Тесты которые НЕ работают
- TEST 1: PIN 50=LOW, PIN 51=HIGH - нет движения
- TEST 2: PIN 50=HIGH, PIN 51=LOW - нет движения
- TEST 4: BOTH HIGH - ???

## Примечание
Актуатор работает ТОЛЬКО когда оба пина установлены в LOW.
Нужно определить как разделить UP и DOWN направления.
