nurdamiron/rams-projects/firmware/PRODUCTION_v3.2_FINAL/esp32/README_UPGRADE.md

# ESP32 Firmware v3.2 - Upgrade Guide

## Что нового в этой версии

### ✅ НОВЫЕ ФИЧИ:
1. **8 LED эффектов** - Rainbow, Pulse, Chase, Sparkle, Wave, Fire, Meteor
2. **Плавное угасание LED** - LED постепенно тускнеет синхронно с опусканием актуатора (вместо резкого выключения)
3. **Управление яркостью** - через API `/api/bri` (0-255)
4. **Управление скоростью** - через API `/api/spd` (0-255)

### 🔧 КАК ПРОШИТЬ ESP32

#### Через Arduino IDE:

1. Откройте **Arduino IDE 2.x**

2. Установите плату ESP32:
   - Tools → Board Manager → поиск "ESP32"
   - Установите "esp32 by Espressif Systems"

3. Выберите плату:
   - Tools → Board → ESP32 Arduino → "ESP32 Dev Module"

4. Выберите порт:
   - Tools → Port → выберите `/dev/cu.usbserial-xxxx`
   - (На Windows: `COMxx`)

5. Откройте файл:
   - File → Open → выберите `rams_controller_v3.ino`

6. Откройте **все TAB-ы** (ACTUATOR_CONFIG.h должен быть открыт!)

7. Нажмите **Upload** (→ стрелка)

8. Дождитесь надписи:
   ```
   Hard resetting via RTS pin...
   ```

9. Откройте Serial Monitor (Tools → Serial Monitor):
   - Установите скорость: **115200 baud**
   - Проверьте вывод:
     ```
     ========================================
       RAMS CONTROLLER v3.2 PRODUCTION
       Actuators + LED Zones + Power Control
       DroneControl Style
     ========================================
     [LED] 10 strips initialized
     [WIFI] Connected to Rams_WIFI!
     [READY] System initialized!
     ```

### 📡 API ENDPOINTS

```bash
# Поднять блок 1 на 5 секунд
POST /api/block?num=1&action=UP&duration=5000

# Опустить блок 1 (с плавным fade LED)
POST /api/block?num=1&action=DOWN&duration=5000

# Остановить все блоки
POST /api/stop

# Установить цвет LED (RGB)
POST /api/color?r=255&g=100&b=0

# Установить яркость LED (0-255)
POST /api/bri?v=200

# Установить эффект (0=Static, 2=Rainbow, ...)
POST /api/effect?id=2&speed=128

# Установить скорость эффекта (0-255)
POST /api/spd?v=150
```

### 🌈 LED ЭФФЕКТЫ

| ID | Название  | Описание |
|----|---|---|
| 0  | Static | Статический цвет |
| 1  | Pulse | Пульсация (breathing) |
| 2  | Rainbow | Радуга (цикл HSV) |
| 3  | Chase | Бегущая точка с хвостом |
| 4  | Sparkle | Искры (случайные вспышки) |
| 5  | Wave | Волна (синусоида) |
| 6  | Fire | Огонь (heat simulation) |
| 7  | Meteor | Метеор (падающая звезда) |

### 🎨 ПЛАВНОЕ УГАСАНИЕ

При команде **DOWN** актуатор опускается, и LED **плавно тускнеет** за то же время:

```
t=0:      LED 100% яркость | Актуатор вверху
t=2.5s:   LED 50% яркость  | Актуатор в середине
t=5s:     LED 0% (выкл)    | Актуатор внизу
```

Синхронная анимация выглядит **плавно и профессионально** ✨

---

**Файл:** `rams_controller_v3.ino`
**Версия:** 3.2 (Production с LED эффектами + Fade)
**Дата:** 2026-02-16
**Автор:** RAMS Global Team
