nurdamiron/rams-projects/firmware/arduino_mega/actuator_mega2_PARTIAL_WORKING/README.md

# ЧАСТИЧНО РАБОЧАЯ ПРОШИВКА - Arduino Mega 2

**Дата:** 15 февраля 2026
**Статус:** ⚠️ ЧАСТИЧНО РАБОТАЕТ (Блоки 9-13)

## Описание

Управляет 7 блоками актуаторов (Blocks 9-15).
Блоки 9-13 работают ✅
Блоки 14-15 НЕ работают ❌ (нужно найти правильные пины)

## Рабочий маппинг пинов (Blocks 9-13)

### Блок 9 (пины 22-25) ✅
- Актуатор 1: UP = 22, DOWN = 23
- Актуатор 2: UP = 24, DOWN = 25

### Блок 10 (пины 26-29) ✅
- Актуатор 1: UP = 26, DOWN = 27
- Актуатор 2: UP = 28, DOWN = 29

### Блок 11 (пины 34-37) ✅ ИСПРАВЛЕНО!
- Актуатор 1: UP = 34, DOWN = 35
- Актуатор 2: UP = 36, DOWN = 37
- **Примечание:** Был перепутан с Block 12

### Блок 12 (пины 30-33) ✅ ИСПРАВЛЕНО!
- Актуатор 1: UP = 30, DOWN = 31
- Актуатор 2: UP = 32, DOWN = 33
- **Примечание:** Был перепутан с Block 11

### Блок 13 (пины 38-41) ✅
- Актуатор 1: UP = 38, DOWN = 39
- Актуатор 2: UP = 40, DOWN = 41

## НЕ работают (нужно найти пины!)

### Блок 14 ❌
- Текущие пины: 42,43,44,45
- **НЕ РАБОТАЕТ!** Нужно найти правильные пины

### Блок 15 ❌
- Текущие пины: 46,47,48,49
- **НЕ РАБОТАЕТ!** Нужно найти правильные пины
- **Важно:** Block 15 имеет 3 актуатора (не 2!)

## Логика реле

**ИНВЕРСНАЯ ЛОГИКА:**
- `LOW` = Реле ВКЛЮЧЕНО (актуатор работает)
- `HIGH` = Реле ВЫКЛЮЧЕНО (актуатор не работает)

## Важные замечания

### ⚠️ Блоки 11 и 12 перепутаны
Физическая проводка:
- Пины 30-33 → Block 12 (не Block 11!)
- Пины 34-37 → Block 11 (не Block 12!)

Это учтено в прошивке!

### ⚠️ Block 15 - 3 актуатора
Block 15 имеет 3 актуатора (не 2 как остальные):
- 2 актуатора на 4-канальном реле
- 1 актуатор на 2-канальном реле

## TODO

- [ ] Найти правильные пины для Block 14
- [ ] Найти правильные пины для Block 15
- [ ] Добавить поддержку 3-го актуатора для Block 15

---

**⚠️ НЕЗАВЕРШЁННАЯ ВЕРСИЯ! ТРЕБУЕТСЯ ДОРАБОТКА! ⚠️**
