nurdamiron/rams-projects/БЫСТРЫЙ-СТАРТ.md

# ⚡ БЫСТРЫЙ СТАРТ - РАЗВЕРТЫВАНИЕ НА WINDOWS

## 🎯 КРАТКАЯ ИНСТРУКЦИЯ (5 МИНУТ)

### 1️⃣ Скачай с GitHub Actions

📥 https://github.com/nurdamiron/rams-projects/actions

Скачай: **windows-executables.zip** (~600 MB)

---

### 2️⃣ Создай структуру папок на Windows

```
C:\RAMS\
├── RAMS-Interactive-Hub-Portable.exe    ← Из zip
└── media\                                ← Создай вручную
    └── projects\                         ← Создай вручную
        └── (сюда медиа)
```

**CMD команды:**
```cmd
mkdir C:\RAMS
mkdir C:\RAMS\media
mkdir C:\RAMS\media\projects
```

---

### 3️⃣ Скопируй медиа-файлы

**С Mac:**
```
Исходник: /Users/nurdauletakhmatov/Desktop/rams-screen/rams-interactive-hub/public/projects/

Скопируй на флешку → Перенеси на Windows → Положи в:
C:\RAMS\media\projects\
```

**Результат:**
```
C:\RAMS\media\projects\
├── rams-city\
│   ├── video-1.mp4
│   ├── photo-1.jpg
│   └── logo.png
├── rams-beyond\
└── ... (все проекты)
```

---

### 4️⃣ Запускай!

Двойной клик на: **C:\RAMS\RAMS-Interactive-Hub-Portable.exe**

---

## ✅ ПРОВЕРКА

После запуска должно быть:
- ✅ Полноэкранный режим
- ✅ Видны карточки проектов
- ✅ Фото загружаются
- ✅ Видео воспроизводятся
- ✅ Переключатель языков работает

---

## 🔧 ГОРЯЧИЕ КЛАВИШИ

| Клавиша | Действие |
|---|---|
| **Ctrl+Q** | Выход из приложения |
| **Ctrl+Shift+A** | Админ-панель (настройки проектов) |
| **Escape** | Закрыть модальное окно |

---

## 🐛 ЕСЛИ ЧТО-ТО НЕ РАБОТАЕТ

### Нет медиа-файлов?
```cmd
# Проверь структуру:
dir C:\RAMS\media\projects\
```
Должны быть папки проектов!

### Windows Defender блокирует?
1. Параметры → Безопасность Windows
2. Защита от вирусов и угроз
3. Исключения → Добавить папку `C:\RAMS\`

### Приложение не запускается?
- Установи Node.js (не обязательно, но может помочь)
- Запусти от имени администратора

---

## 📊 ИТОГОВАЯ СТРУКТУРА

```
C:\RAMS\
├── RAMS-Interactive-Hub-Portable.exe      (300 MB)
└── media\
    └── projects\
        ├── rams-city\                      (500 MB)
        ├── rams-beyond\                    (300 MB)
        ├── grande-vie\                     (400 MB)
        └── ... (всего ~5 GB)
```

---

## 💡 СОВЕТ

**Для быстрого тестирования:**
Можешь сначала скопировать только 1-2 проекта с медиа, чтобы проверить что всё работает!

---

**Готово!** 🎉
