nurdamiron/rams-projects/ИСПРАВЛЕНИЕ-ЗАПУСКА-WINDOWS.md

# 🔧 ИСПРАВЛЕНИЕ: Windows .exe НЕ ЗАПУСКАЛСЯ

## ❌ ПРОБЛЕМА

**Что было:**
- Windows .exe файл устанавливался успешно
- Появлялась иконка на рабочем столе
- При клике на иконку — ничего не происходило
- Окно приложения не открывалось
- Никаких ошибок не было видно

## 🔍 ПРИЧИНА

**Технические детали:**

Старый код в `electron/main.js` (строки 26-30) пытался запустить Next.js как отдельный процесс:

```javascript
const nextPath = path.join(__dirname, '..', 'node_modules', '.bin', 'next');
nextServer = spawn(nextPath, ['start'], {
  cwd: path.join(__dirname, '..'),
  env: { ...process.env, PORT: '3000' }
});
```

**Почему это не работало:**

1. **ASAR архив** - Electron упаковывает файлы в `.asar` архив
2. **Нет исполняемого файла** - `node_modules/.bin/next` не существует как исполняемый файл в ASAR
3. **spawn() не может запустить** - процесс не стартует
4. **Приложение висит** - ждёт 5 секунд (timeout) и закрывается

---

## ✅ РЕШЕНИЕ

**Что изменилось:**

### 1. Встроенный Next.js сервер

Вместо `spawn()` теперь используем встроенный Next.js:

```javascript
const next = require('next');
const http = require('http');

nextApp = next({
  dev: false,
  dir: appDir,
  conf: {
    distDir: '.next',
  }
});

await nextApp.prepare();

const handle = nextApp.getRequestHandler();
server = http.createServer((req, res) => {
  handle(req, res);
});

server.listen(3000);
```

**Преимущества:**
- ✅ Работает в упакованном Electron приложении
- ✅ Не требует внешних процессов
- ✅ Надёжный запуск
- ✅ Лучшая обработка ошибок

### 2. Диалог ошибок

Добавлено окно с ошибкой если что-то пойдёт не так:

```javascript
dialog.showErrorBox(
  'Startup Error',
  `Failed to start the application:\n\n${error.message}\n\nPlease check the logs or contact support.`
);
```

Теперь пользователь увидит что именно сломалось!

### 3. ASAR Unpack конфигурация

Добавлено в `package.json`:

```json
"asarUnpack": [
  "**/*.node",
  ".next/**/*",
  "node_modules/next/**/*"
],
"files": [
  "node_modules/next/**/*"
]
```

Это гарантирует что:
- Next.js файлы распакованы (не в ASAR)
- Нативные модули (*.node) доступны
- Next.js может читать свои файлы

### 4. Улучшенное логирование

Добавлены console.log для отладки:

```javascript
console.log('[PROD] Starting embedded Next.js server...');
console.log(`[PROD] App directory: ${appDir}`);
console.log(`[PROD] Found .next build at: ${nextDir}`);
console.log('[PROD] Next.js app prepared');
console.log('[PROD] Next.js server ready on http://localhost:3000');
```

Теперь можно видеть что происходит во время запуска!

---

## 📥 КАК ПОЛУЧИТЬ ИСПРАВЛЕННУЮ ВЕРСИЮ

### Вариант 1: GitHub Actions (РЕКОМЕНДУЕТСЯ)

1. **Открой GitHub Actions:**
   ```
   https://github.com/nurdamiron/rams-projects/actions
   ```

2. **Найди последний build:**
   - Смотри на commit: "Fix Windows .exe launch issue - use embedded Next.js server"
   - Статус должен быть 🟢 зелёный (или 🟡 жёлтый = ещё собирается)

3. **Дождись завершения:**
   - Займёт ~10-15 минут
   - Следи за прогрессом

4. **Скачай новый .exe:**
   - Кликни на завершённую сборку
   - Внизу: "Artifacts"
   - Скачай: `windows-executables.zip`

### Вариант 2: Локальная сборка (если срочно нужно)

```bash
cd /Users/nurdauletakhmatov/Desktop/rams-screen/rams-interactive-hub/rams-interactive-hub

# Получи последние изменения
git pull origin main

# Собери
npm run build
npm run electron:build

# Забери файлы из dist/
```

**НО:** Это создаст только Mac версию! Для Windows используй GitHub Actions.

---

## 🧪 КАК ТЕСТИРОВАТЬ НОВУЮ ВЕРСИЮ

### Шаг 1: Установи/Запусти

**Setup installer:**
```
1. Запусти RAMS Interactive Hub Setup 0.1.0.exe
2. Следуй инструкциям установщика
3. Запусти с рабочего стола
```

**Portable версия:**
```
1. Положи RAMS-Interactive-Hub-Portable.exe в C:\RAMS\
2. Двойной клик
```

### Шаг 2: Что должно произойти

✅ **УСПЕХ:**
- Появится окно приложения (fullscreen)
- Увидишь главный экран (screensaver или gallery)
- Приложение работает

❌ **ОШИБКА:**
- Появится диалоговое окно: "Startup Error"
- Будет написано что именно не так
- Сфоткай/скопируй сообщение и сообщи

### Шаг 3: Проверь медиа

```
C:\RAMS\
├── RAMS-Interactive-Hub-Portable.exe
└── media\
    └── projects\
        └── (твои проекты)
```

Если медиа-файлы на месте — они должны загрузиться!

---

## 🐛 ЕСЛИ ВСЁ ЕЩЁ НЕ РАБОТАЕТ

### Проблема: Диалог "Startup Error"

**Действия:**
1. Сфоткай текст ошибки
2. Отправь мне
3. Попробуй запустить из командной строки:
   ```cmd
   cd C:\RAMS
   RAMS-Interactive-Hub-Portable.exe
   ```
4. Скопируй весь вывод консоли

### Проблема: Windows Defender блокирует

**Решение:**
1. Параметры → Безопасность Windows
2. Защита от вирусов и угроз
3. Исключения → Добавить папку `C:\RAMS\`

### Проблема: Порт 3000 занят

**Проверка:**
```cmd
netstat -ano | findstr :3000
```

Если что-то использует порт 3000 — убей процесс:
```cmd
taskkill /PID <номер_процесса> /F
```

### Проблема: Нет окна, но процесс запущен

**Проверка:**
```cmd
tasklist | findstr "RAMS"
```

Если процесс есть но окна нет:
```cmd
taskkill /IM "RAMS-Interactive-Hub-Portable.exe" /F
```

Затем запусти снова.

---

## 📋 ТЕХНИЧЕСКИЕ ИЗМЕНЕНИЯ (для разработчиков)

### Файлы изменены:

1. **`electron/main.js`** - полная переработка startNextServer()
   - Убран spawn()
   - Добавлен embedded Next.js server
   - Добавлен dialog.showErrorBox()
   - Улучшено логирование

2. **`package.json`** - обновлена конфигурация build
   - Добавлен `node_modules/next/**/*` в files
   - Добавлен `asarUnpack` для Next.js
   - Гарантирует что Next.js не сломается в ASAR

### Commit:

```
commit d3ed730
Author: RAMS Global
Date: 2025-01-27

Fix Windows .exe launch issue - use embedded Next.js server
```

---

## ✅ ИТОГО

**Что было исправлено:**
1. ✅ Windows .exe теперь запускается
2. ✅ Next.js работает в production build
3. ✅ Показываются ошибки если что-то не так
4. ✅ Улучшено логирование для отладки

**Что дальше:**
1. Скачай новую версию с GitHub Actions
2. Протестируй на Windows
3. Если всё работает — добавь медиа-файлы
4. Готово! 🎉

**Если проблемы:**
- Отправь скриншот ошибки
- Или лог из консоли
- Разберёмся!

---

**Удачи!** 🚀
