nurdamiron/rams-projects/ИТОГИ-И-ЧТО-ДЕЛАТЬ.md

# 📊 ИТОГИ РАБОТЫ И ЧТО ДЕЛАТЬ ДАЛЬШЕ

## ✅ ЧТО СДЕЛАНО

1. **✅ Получены последние изменения из Git**
   - Добавлена мультиязычность (RU/KK/TR/EN)
   - Обновлены все компоненты
   - Добавлен переключатель языков

2. **✅ Установлены зависимости**
   - `npm install` выполнен успешно
   - Все библиотеки актуальны

3. **✅ Собрано Next.js приложение**
   - `.next/` папка создана
   - Приложение готово к запуску

4. **✅ Создана документация**
   - `BUILD_ON_WINDOWS.md` - инструкция для сборки на Windows
   - `ИТОГИ-И-ЧТО-ДЕЛАТЬ.md` - этот файл

---

## ❌ ЧТО НЕ ПОЛУЧИЛОСЬ

**Windows .exe файлы НЕ собрались!**

**Причина:** На Mac нельзя собрать Windows .exe без специальных инструментов (wine/docker).

---

## 🎯 ЧТО НУЖНО СДЕЛАТЬ

### ВАРИАНТ 1: Собрать на Windows машине (РЕКОМЕНДУЮ!) ✅

**Это самый простой и надежный способ!**

#### Шаг 1: Перенеси проект на Windows

```bash
# Текущая локация на Mac:
/Users/nurdauletakhmatov/Desktop/rams-screen/rams-interactive-hub/

# Перенеси ЭТУ ПАПКУ на Windows через:
# - Флешку
# - Google Drive / Dropbox
# - Git clone
```

#### Шаг 2: На Windows выполни

```cmd
# Открой CMD/PowerShell
cd C:\путь\к\rams-interactive-hub

# Установи зависимости
npm install

# Собери приложение
npm run electron:build
```

#### Шаг 3: Забери файлы

```
dist/
├── RAMS Interactive Hub Setup 0.1.0.exe    ← Установщик
└── RAMS-Interactive-Hub-Portable.exe       ← Портативная версия
```

**⏱️ Займёт 10-15 минут на Windows**

**📖 Подробная инструкция:** `BUILD_ON_WINDOWS.md`

---

### ВАРИАНТ 2: Используй старые .exe (БЕЗ мультиязычности) ⚠️

Если срочно нужны .exe и нет времени собирать:

```bash
# Старые файлы (24 января):
/Users/nurdauletakhmatov/Desktop/rams-screen/rams-interactive-hub/dist/

# Но в них НЕТ:
# ❌ Мультиязычности (RU/KK/TR/EN)
# ❌ Последних исправлений
# ❌ Обновлённого UI
```

**Не рекомендую!** Лучше собрать новые на Windows.

---

## 📂 СТРУКТУРА ПРОЕКТА СЕЙЧАС

```
/Users/nurdauletakhmatov/Desktop/rams-screen/rams-interactive-hub/
├── app/                          ← React приложение
├── components/                   ← UI компоненты
├── electron/                     ← Electron код
├── lib/                          ← Библиотеки, типы
│   ├── i18n/                     ← Мультиязычность (НОВОЕ!)
│   ├── hardware/                 ← Hardware интеграция
│   └── data/projects.ts          ← База проектов
├── public/                       ← Статика (логотипы, иконки)
├── .next/                        ← Собранный Next.js ✅
├── node_modules/                 ← Зависимости ✅
├── dist/                         ← macOS .dmg (НЕ Windows!)
│   ├── RAMS Interactive Hub-0.1.0-arm64.dmg
│   └── RAMS Interactive Hub-0.1.0-arm64-mac.zip
│
├── BUILD_ON_WINDOWS.md           ← Инструкция для сборки ✅
├── ИТОГИ-И-ЧТО-ДЕЛАТЬ.md         ← Этот файл ✅
├── package.json                  ← Конфигурация
└── README.md                     ← Описание проекта
```

---

## 🔍 ПРОВЕРКА РАБОТОСПОСОБНОСТИ

### Запуск в режиме разработки (на Mac):

```bash
cd /Users/nurdauletakhmatov/Desktop/rams-screen/rams-interactive-hub

# Запуск Next.js dev сервера
npm run dev
# Откроется: http://localhost:3000

# ИЛИ запуск Electron + Next.js
npm run electron:dev
```

**Проверь:**
- ✅ Приложение открывается
- ✅ Видны карточки проектов
- ✅ Переключатель языков работает (RU/KK/TR/EN)
- ✅ Модальные окна открываются

---

## 🚀 ПОСЛЕ СБОРКИ НА WINDOWS

### Что получится:

```
dist/
├── RAMS Interactive Hub Setup 0.1.0.exe    (~300 MB)
└── RAMS-Interactive-Hub-Portable.exe       (~300 MB)
```

### Как развернуть на киоске:

```
C:\RAMS\
├── RAMS-Interactive-Hub-Portable.exe   ← Запускаемый файл
└── media\
    └── projects\
        ├── 01-rams-beyond-st-regis\
        │   ├── video-1.mp4
        │   ├── photo-1.jpg
        │   └── logo.png
        ├── 02-rams-city\
        └── ... (все остальные)
```

### Запуск:

```
1. Двойной клик на RAMS-Interactive-Hub-Portable.exe
2. Приложение откроется в полноэкранном режиме
3. Для выхода: Ctrl+Q
4. Для настроек: Ctrl+Shift+A
```

---

## 🎨 НОВЫЕ ВОЗМОЖНОСТИ (после обновления)

### Мультиязычность 🌐
- **4 языка:** Русский, Казахский, Турецкий, Английский
- Переключатель в правом верхнем углу
- Переводы для ВСЕХ UI элементов
- Переводы для ~50 проектов

### Обновлённый UI
- Скринсейвер с часами и датой
- Плавные анимации
- Адаптивный дизайн
- Светлая/тёмная тема

### Hardware интеграция
- Поддержка WiFi (ESP32)
- Поддержка Serial (Arduino)
- Debouncing и auto-reconnect
- Health checks

---

## 📞 ЕСЛИ ЧТО-ТО НЕ РАБОТАЕТ

### Проблема: "Приложение не открывается на Windows"
**Причина:** Старые .exe файлы или неправильная сборка

**Решение:**
1. Собери НОВУЮ версию на Windows (см. BUILD_ON_WINDOWS.md)
2. Проверь что Node.js установлен
3. Проверь что npm install прошёл без ошибок

### Проблема: "Нет медиа-файлов"
**Причина:** Медиа не в правильной папке

**Решение:**
```
1. Создай C:\RAMS\media\projects\
2. Скопируй туда все папки проектов
3. Перезапусти приложение
```

### Проблема: "Не переключается язык"
**Причина:** Старая версия приложения

**Решение:**
1. Убедись что собрал НОВУЮ версию (после git pull)
2. Проверь что в коде есть папка lib/i18n/
3. Пересобери: npm run build && npm run electron:build

---

## ✨ СЛЕДУЮЩИЕ ШАГИ

- [ ] 1. Перенеси проект на Windows машину
- [ ] 2. Выполни `npm install`
- [ ] 3. Выполни `npm run electron:build`
- [ ] 4. Забери .exe файлы из dist/
- [ ] 5. Подготовь медиа-файлы (C:\RAMS\media\)
- [ ] 6. Протестируй на Windows
- [ ] 7. Разверни на киоске

---

## 📊 КРАТКАЯ СПРАВКА

| Что | Где | Статус |
|-----|-----|---|
| Исходный код | `/Users/.../rams-interactive-hub/` | ✅ Актуальный |
| Зависимости | `node_modules/` | ✅ Установлены |
| Next.js build | `.next/` | ✅ Собран |
| Windows .exe | `dist/` | ❌ Нужно собрать на Windows |
| Медиа-файлы | Отдельно | ⚠️ Нужно подготовить |
| Документация | `BUILD_ON_WINDOWS.md` | ✅ Готова |

---

## 💡 РЕКОМЕНДАЦИИ

1. **Для production:**
   - Собирай ТОЛЬКО на Windows
   - Используй Portable.exe (без установки)
   - Храни медиа отдельно (в C:\RAMS\media\)

2. **Для обновлений:**
   - Только код: просто замени .exe
   - Медиа: не трогай, они отдельно
   - Конфиг: хранится в localStorage браузера

3. **Для резервного копирования:**
   - Скопируй папку C:\RAMS\ целиком
   - Сохрани исходники проекта
   - Запиши настройки (Ctrl+Shift+A)

---

**Удачи с развертыванием!** 🚀

Если возникнут вопросы - пиши! 😊
