nurdamiron/rams-projects/КАК-ПОЛУЧИТЬ-ЛОГ-ФАЙЛ.md

# 🔍 КАК ПОЛУЧИТЬ ЛОГ-ФАЙЛ ДЛЯ ДИАГНОСТИКИ

## Проблема

Windows .exe запускается, но ничего не происходит - нет окна, нет ошибки, просто тишина.

## Решение

Приложение теперь записывает подробные логи в файл. Давай найдём этот файл!

---

## 📁 ГДЕ НАЙТИ ЛОГ-ФАЙЛ

### Windows (Portable версия)

Лог-файл находится здесь:

```
C:\Users\<ИМЯ_ПОЛЬЗОВАТЕЛЯ>\AppData\Roaming\rams-interactive-hub\rams-app.log
```

**Полный путь (пример):**
```
C:\Users\Administrator\AppData\Roaming\rams-interactive-hub\rams-app.log
```

### Windows (Installed версия)

То же самое место:
```
C:\Users\<ИМЯ_ПОЛЬЗОВАТЕЛЯ>\AppData\Roaming\rams-interactive-hub\rams-app.log
```

---

## 🔎 КАК ОТКРЫТЬ ПАПКУ С ЛОГОМ

### Вариант 1: Через Проводник

1. Открой Проводник (Win+E)
2. Вставь в адресную строку:
   ```
   %APPDATA%\rams-interactive-hub
   ```
3. Нажми Enter
4. Найди файл `rams-app.log`

### Вариант 2: Через команду

1. Открой **Выполнить** (Win+R)
2. Вставь:
   ```
   %APPDATA%\rams-interactive-hub
   ```
3. Нажми ОК
4. Найди файл `rams-app.log`

### Вариант 3: Через CMD

```cmd
cd %APPDATA%\rams-interactive-hub
dir
notepad rams-app.log
```

---

## 📖 ЧТО ДЕЛАТЬ С ЛОГ-ФАЙЛОМ

### Шаг 1: Запусти приложение

Попробуй запустить `RAMS-Interactive-Hub-Portable.exe` или установленную версию.

Даже если ничего не происходит — лог записывается!

### Шаг 2: Открой лог-файл

```cmd
notepad %APPDATA%\rams-interactive-hub\rams-app.log
```

Или просто найди файл в Проводнике и открой в Блокноте.

### Шаг 3: Скопируй содержимое

Выдели весь текст (Ctrl+A) и скопируй (Ctrl+C).

### Шаг 4: Отправь мне

Вставь текст лога в наш чат. Это покажет:
- Где именно происходит сбой
- Какая ошибка возникает
- Почему приложение не запускается

---

## 📋 ЧТО ОЖИДАТЬ В ЛОГЕ

### Успешный запуск:

```
[2026-01-27T13:30:00.000Z] === RAMS Interactive Hub Starting ===
[2026-01-27T13:30:00.100Z] App version: 0.1.0
[2026-01-27T13:30:00.200Z] Electron version: 39.2.7
[2026-01-27T13:30:00.300Z] Platform: win32
[2026-01-27T13:30:01.000Z] App ready event fired
[2026-01-27T13:30:01.100Z] Calling startNextServer...
[2026-01-27T13:30:01.200Z] [PROD] Starting embedded Next.js server...
[2026-01-27T13:30:01.300Z] [PROD] Requiring next module...
[2026-01-27T13:30:02.000Z] [PROD] Next module loaded successfully
...
[2026-01-27T13:30:05.000Z] [PROD] Next.js server ready on http://localhost:3000
[2026-01-27T13:30:05.100Z] Creating main window...
[2026-01-27T13:30:05.200Z] Main window created successfully
[2026-01-27T13:30:06.000Z] Page loaded successfully
[2026-01-27T13:30:06.100Z] Application started successfully!
```

### Если есть ошибка:

```
[2026-01-27T13:30:00.000Z] === RAMS Interactive Hub Starting ===
[2026-01-27T13:30:01.000Z] App ready event fired
[2026-01-27T13:30:01.100Z] Calling startNextServer...
[2026-01-27T13:30:01.200Z] [PROD] Starting embedded Next.js server...
[2026-01-27T13:30:01.300Z] [PROD] Requiring next module...
[2026-01-27T13:30:01.400Z] FATAL ERROR: Cannot find module 'next'
[2026-01-27T13:30:01.500Z] Error stack: ...
```

В логе будет видно **ТОЧНУЮ** причину!

---

## 🚨 ВОЗМОЖНЫЕ ОШИБКИ

### Ошибка 1: "Cannot find module 'next'"

**Причина:** Next.js не включён в build
**Решение:** Я исправлю конфигурацию сборки

### Ошибка 2: ".next directory not found"

**Причина:** Билд Next.js не включён
**Решение:** Нужно убедиться что .next/ упаковывается

### Ошибка 3: "Port 3000 already in use"

**Причина:** Другое приложение использует порт 3000
**Решение:** Закрой другие приложения или перезагрузи Windows

### Ошибка 4: "Failed to start HTTP server"

**Причина:** Проблема с сетевым стеком
**Решение:** Проверь файрвол / антивирус

---

## 🔥 БЫСТРАЯ ДИАГНОСТИКА

### Команды для проверки:

```cmd
# 1. Проверь что порт 3000 свободен
netstat -ano | findstr :3000

# 2. Проверь что приложение запускается
tasklist | findstr "RAMS"

# 3. Открой лог сразу после запуска
timeout 10 && notepad %APPDATA%\rams-interactive-hub\rams-app.log
```

### Полная команда диагностики:

```cmd
@echo off
echo === RAMS Diagnostic ===
echo.

echo [1] Checking if port 3000 is free...
netstat -ano | findstr :3000
echo.

echo [2] Trying to start RAMS...
start "" "C:\RAMS\RAMS-Interactive-Hub-Portable.exe"
echo.

echo [3] Waiting 5 seconds...
timeout /t 5 /nobreak
echo.

echo [4] Checking if RAMS is running...
tasklist | findstr "RAMS"
echo.

echo [5] Opening log file...
notepad %APPDATA%\rams-interactive-hub\rams-app.log
```

Сохрани это как `diagnose.bat` и запусти!

---

## 📸 ЧТО МНЕ ОТПРАВИТЬ

### Вариант 1: Текст лога (лучше)

```cmd
# Скопируй ВСЁ содержимое и отправь:
notepad %APPDATA%\rams-interactive-hub\rams-app.log
```

### Вариант 2: Скриншот

Если лог-файл большой - сделай скриншот:
1. Открой лог в Блокноте
2. Покажи **последние 50 строк** (конец файла)
3. Сделай скриншот
4. Отправь мне

---

## ✅ СЛЕДУЮЩИЕ ШАГИ

1. **Запусти** новую версию .exe (скоро будет готова с логированием)
2. **Дождись** 10 секунд
3. **Открой** лог-файл: `%APPDATA%\rams-interactive-hub\rams-app.log`
4. **Скопируй** весь текст
5. **Отправь** мне в чат

После этого я точно узнаю в чём проблема и исправлю! 💪

---

## 🎯 ВАЖНО

**Даже если приложение "ничего не делает" - ЛОГ ЗАПИСЫВАЕТСЯ!**

Просто открой файл лога и отправь мне. Там будет вся информация о том, что пошло не так.

---

**Жду твой лог!** 🔍
