nurdamiron/rams-projects/ПРАВИЛЬНАЯ-УСТАНОВКА.md

# ✅ ПРАВИЛЬНАЯ УСТАНОВКА НА WINDOWS

## 📁 СТРУКТУРА ФАЙЛОВ

### ГДЕ ДОЛЖНО БЫТЬ ВСЁ:

```
C:\RAMS\
├── RAMS-Interactive-Hub-Portable.exe    ← Исполняемый файл
└── media\                                ← Папка с медиа
    └── projects\                         ← Папка с проектами
        ├── rams-city\
        │   ├── video-1.mp4
        │   ├── photo-1.jpg
        │   └── logo.png
        ├── rams-beyond\
        │   └── ...
        ├── grande-vie\
        │   └── ...
        └── ... (все остальные проекты)
```

---

## 🚀 БЫСТРАЯ УСТАНОВКА (5 МИНУТ)

### Шаг 1: Создай папку

```cmd
mkdir C:\RAMS
mkdir C:\RAMS\media
mkdir C:\RAMS\media\projects
```

### Шаг 2: Перемести .exe файл

Скопируй/перемести `RAMS-Interactive-Hub-Portable.exe` в `C:\RAMS\`

### Шаг 3: Скопируй медиа-файлы

**С Mac (если есть доступ):**
```
Исходник: /Users/nurdauletakhmatov/Desktop/rams-screen/rams-interactive-hub/public/projects/

Способы переноса:
1. USB флешка
2. Облако (Google Drive, Dropbox)
3. Сетевая папка
```

**Куда положить:**
```
Все папки проектов → C:\RAMS\media\projects\
```

**Результат:**
```
C:\RAMS\media\projects\
├── rams-city\
├── rams-beyond\
├── grande-vie\
└── ... (все проекты)
```

### Шаг 4: Запусти

Двойной клик: `C:\RAMS\RAMS-Interactive-Hub-Portable.exe`

---

## ⚠️ ВАЖНО!

### Не делай так:

❌ **НЕ ОСТАВЛЯЙ на рабочем столе** - долгий путь, может быть проблема с правами

❌ **НЕ клади в Program Files** - нужны права администратора

❌ **НЕ называй папку по-другому** - приложение ищет именно "media"

### Делай так:

✅ **Клади в C:\RAMS\** - короткий путь, без проблем с правами

✅ **Называй папки точно как написано** - media, projects

✅ **Сохраняй структуру проектов** - каждый проект в своей папке

---

## 🔧 ИСПРАВЛЕНИЯ В НОВОЙ ВЕРСИИ

### Что исправлено:

1. ✅ **Иконки** - добавлены шрифты в build (теперь не текст, а символы)
2. ✅ **Логирование** - подробные логи для диагностики
3. ✅ **Встроенный Next.js** - не нужны внешние процессы

### Новая версия сейчас собирается:

Проверяй здесь: https://github.com/nurdamiron/rams-projects/actions

Commit: "Fix: Include fonts in Electron build to fix icon display"

**Через ~5-10 минут** будет готова версия с исправленными иконками!

---

## 📥 КАК СКАЧАТЬ НОВУЮ ВЕРСИЮ

### Вариант 1: GitHub Actions (рекомендую)

1. Открой: https://github.com/nurdamiron/rams-projects/actions
2. Найди последнюю сборку (самую верхнюю с 🟢 зелёным статусом)
3. Пролистай вниз до "Artifacts"
4. Скачай: **Windows-Portable**
5. Распакуй zip
6. Перемести .exe в `C:\RAMS\`

### Вариант 2: GitHub Releases (когда будет)

1. Открой: https://github.com/nurdamiron/rams-projects/releases
2. Скачай последний релиз
3. Установи

---

## 🎯 ЧЕКЛИСТ УСТАНОВКИ

- [ ] Создал `C:\RAMS\`
- [ ] Создал `C:\RAMS\media\`
- [ ] Создал `C:\RAMS\media\projects\`
- [ ] Скопировал .exe в `C:\RAMS\`
- [ ] Скопировал проекты в `C:\RAMS\media\projects\`
- [ ] Запустил приложение
- [ ] Увидел главный экран (не текст, а иконки!)
- [ ] Медиа загружаются

---

## 🐛 ЕСЛИ ЧТО-ТО НЕ ТАК

### Иконки всё ещё текст?

Значит старая версия. Скачай новую с GitHub Actions (через ~10 минут).

### Долго загружается (несколько минут)?

Нормально для первого запуска Next.js сервера. Следующие запуски будут быстрее.

### Медиа не загружаются?

Проверь путь: `C:\RAMS\media\projects\<имя-проекта>\`

Должны быть:
- Папки проектов
- Внутри файлы (mp4, jpg, png)

### Всё ещё не работает?

Открой лог: `%APPDATA%\rams-interactive-hub\rams-app.log`

Отправь содержимое для диагностики.

---

## 💡 СОВЕТ

**Для тестирования:**

Можешь сначала скопировать только 1-2 проекта с медиа, чтобы проверить что всё работает!

Не нужно сразу копировать все 5GB.

---

## ⏱️ ТАЙМИНГ

### Первый запуск:
- Загрузка Next.js: **1-2 минуты**
- Потом приложение откроется
- **Нормально!**

### Последующие запуски:
- Будут быстрее: **30-60 секунд**

### В будущем:
- Можем оптимизировать до **5-10 секунд**
- Но сейчас работает, и это главное! ✅

---

## 🎉 ГОТОВО!

После правильной установки ты получишь:
- ✅ Полноэкранное приложение
- ✅ Красивые иконки (не текст!)
- ✅ Все медиа загружаются
- ✅ Переключение языков работает
- ✅ Горячие клавиши (Ctrl+Q для выхода)

**Удачи!** 🚀
