nurdamiron/rams-projects/РЕШЕНИЕ-БЕЗ-ИНТЕРНЕТА.md

# 💡 ВСЕ ВАРИАНТЫ СБОРКИ (БЕЗ ИНТЕРНЕТА НА WINDOWS)

## 📊 СРАВНЕНИЕ

| Вариант | Нужен интернет | Где | Время | Сложность | Рекомендую |
|---|---|-----|---|---|---|
| **GitHub Actions** | ✅ На Mac | Mac + GitHub | 10 мин | 😊 Легко | ⭐⭐⭐⭐⭐ |
| **Docker на Mac** | ✅ На Mac | Mac | 15-30 мин | 😐 Средне | ⭐⭐⭐⭐ |
| **Полный пакет** | ❌ | Mac | 5 мин | 😊 Легко | ⭐⭐⭐ |
| **Windows с инетом** | ✅ На Windows | Windows | 15 мин | 😊 Легко | ⭐⭐ |

---

## 🥇 ВАРИАНТ 1: GITHUB ACTIONS (ЛУЧШИЙ!)

### ✅ Плюсы
- Бесплатно
- Автоматически
- Не нужен Windows
- Не нужен интернет на Windows

### 📋 Шаги

**1. Открой GitHub Actions:**
```
https://github.com/nurdamiron/rams-projects/actions
```

**2. Запусти workflow:**
- Кликни "Build Windows Executable" (слева)
- Кликни "Run workflow" (справа)
- Выбери ветку "main"
- Кликни зелёную кнопку "Run workflow"

**3. Подожди 5-10 минут**
- Статус: 🟡 Жёлтый → 🟢 Зелёный

**4. Скачай готовые файлы:**
- Открой завершённую сборку
- Внизу: "Artifacts"
- Скачай: "windows-executables.zip"

**5. Перенеси на Windows:**
- Распакуй zip
- Скопируй .exe на флешку
- Запускай на Windows!

---

## 🐳 ВАРИАНТ 2: DOCKER НА MAC

### ✅ Плюсы
- Работает на Mac
- Не нужен Windows
- Offline сборка (после установки Docker)

### ❌ Минусы
- Нужен Docker (500 MB)
- Долго первый раз (20-30 мин)

### 📋 Шаги

**1. Установи Docker:**
```bash
# Скачай: https://www.docker.com/products/docker-desktop/
# Или через Homebrew:
brew install --cask docker
```

**2. Собери через Docker:**
```bash
cd /Users/nurdauletakhmatov/Desktop/rams-screen/rams-interactive-hub

docker run --rm -ti \
  -v $(pwd):/project \
  electronuserland/builder:wine \
  /bin/bash -c "cd /project && npm install && npm run build && npm run electron:build"
```

**3. Забери файлы:**
```
dist/
├── RAMS Interactive Hub Setup 0.1.0.exe
└── RAMS-Interactive-Hub-Portable.exe
```

---

## 📦 ВАРИАНТ 3: ПОЛНЫЙ ПАКЕТ НА ФЛЕШКЕ

### Идея
Собрать на Mac всё что нужно, перенести на Windows и собрать там БЕЗ интернета.

### ❌ ПРОБЛЕМА
**Не работает!** Electron имеет нативные модули (serialport), которые:
- Компилируются под конкретную платформу
- Mac версия ≠ Windows версия
- Просто скопировать node_modules не получится

### Если всё равно хочешь попробовать:

**1. На Mac:**
```bash
# Подготовь всё
cd /Users/nurdauletakhmatov/Desktop/rams-screen/rams-interactive-hub
npm install
npm run build

# Упакуй весь проект
tar -czf rams-full-project.tar.gz .
```

**2. На Windows:**
```cmd
# Распакуй
tar -xzf rams-full-project.tar.gz

# ПРОБЛЕМА: node_modules для Mac, не для Windows!
# Нужно переустановить:
rm -rf node_modules
npm install  # ← Нужен интернет!
```

**Вывод:** Не подходит для Windows без интернета! ❌

---

## 💻 ВАРИАНТ 4: WINDOWS С ИНТЕРНЕТОМ

### Если найдёшь Windows с интернетом

```cmd
# 1. Скопируй проект на Windows
# 2. Открой CMD
cd C:\rams-interactive-hub

# 3. Установи зависимости
npm install

# 4. Собери
npm run electron:build

# 5. Забери .exe из dist/
```

---

## 🎯 МОИ РЕКОМЕНДАЦИИ

### Для тебя (без интернета на Windows):

**1️⃣ Используй GitHub Actions** (ЛУЧШИЙ!)
- Заходишь на GitHub
- Нажимаешь кнопку
- Через 10 минут скачиваешь .exe
- **Готово!**

**2️⃣ Если GitHub Actions не работает → Docker**
- Установи Docker Desktop
- Запусти одну команду
- Через 20 минут готово

**3️⃣ Последний вариант → найди Windows с интернетом**
- У друга / на работе / в кафе
- Собери там за 15 минут
- Забери .exe на флешку

---

## 📞 ПОМОЩЬ

### GitHub Actions не работает?
1. Проверь что workflow запушен (я уже сделал)
2. Зайди: https://github.com/nurdamiron/rams-projects/actions
3. Если ошибка — пришли скриншот

### Docker не работает?
1. Убедись что Docker запущен
2. Дай ему доступ к диску в настройках
3. Пришли ошибку

### Вообще ничего не работает?
Напиши мне:
- Что пробовал
- Какая ошибка
- Скриншот

Разберёмся! 💪

---

## ✅ ЧЕКЛИСТ

**Для GitHub Actions:**
- [ ] Открыл https://github.com/nurdamiron/rams-projects/actions
- [ ] Нажал "Run workflow"
- [ ] Дождался зелёного статуса
- [ ] Скачал windows-executables.zip
- [ ] Перенёс на Windows

**Для Docker:**
- [ ] Установил Docker Desktop
- [ ] Запустил Docker
- [ ] Выполнил команду сборки
- [ ] Забрал .exe из dist/

---

**Удачи!** 🚀
