nurdamiron/rams-projects/СБОРКА-ЧЕРЕЗ-GITHUB.md

# 🚀 АВТОМАТИЧЕСКАЯ СБОРКА ЧЕРЕЗ GITHUB ACTIONS

## ✅ ЧТО ЭТО ДАЁТ

- **Бесплатная сборка** Windows .exe в облаке GitHub
- **Не нужен Windows** с интернетом
- **Автоматически** при каждом обновлении кода
- Готовые файлы **скачиваешь одним кликом**

---

## 📋 ИНСТРУКЦИЯ (ШАГ ЗА ШАГОМ)

### Шаг 1: Запушь код на GitHub

```bash
cd /Users/nurdauletakhmatov/Desktop/rams-screen/rams-interactive-hub

# Добавь workflow файл
git add .github/workflows/build-windows.yml
git commit -m "Add GitHub Actions for Windows build"
git push origin main
```

---

### Шаг 2: Открой GitHub Actions

1. Перейди на GitHub: https://github.com/nurdamiron/rams-projects
2. Вкладка **"Actions"** (сверху)
3. Увидишь workflow: **"Build Windows Executable"**

---

### Шаг 3: Запусти сборку вручную

1. Кликни на **"Build Windows Executable"** (слева)
2. Кликни **"Run workflow"** (справа)
3. Выбери ветку: **main**
4. Кликни **"Run workflow"** (зелёная кнопка)

---

### Шаг 4: Дождись сборки

- ⏱️ Займёт **5-10 минут**
- Увидишь статус: 🟡 Жёлтый (идёт) → 🟢 Зелёный (готово)
- Если 🔴 Красный — ошибка, напиши мне

---

### Шаг 5: Скачай готовые файлы

1. Кликни на завершённую сборку
2. Внизу страницы: **"Artifacts"**
3. Скачай: **"windows-executables.zip"**

**Внутри будут:**
```
windows-executables.zip
├── RAMS Interactive Hub Setup 0.1.0.exe    (Установщик)
└── RAMS-Interactive-Hub-Portable.exe       (Портативная версия)
```

---

### Шаг 6: Перенеси на Windows

1. Распакуй zip
2. Скопируй .exe файлы на флешку
3. Перенеси на Windows (без интернета)
4. Запускай!

---

## 🎯 АВТОМАТИЧЕСКАЯ СБОРКА

После настройки, каждый раз когда ты делаешь `git push`:
- GitHub **автоматически** соберёт новые .exe
- Ты просто **скачиваешь** готовые файлы

---

## 💡 ДОПОЛНИТЕЛЬНЫЕ ВОЗМОЖНОСТИ

### Сборка с тегами (релизы)

```bash
# Создай релиз
git tag v1.0.0
git push origin v1.0.0

# GitHub создаст Release с .exe файлами
# Скачать можно тут: https://github.com/nurdamiron/rams-projects/releases
```

---

## 🐛 РЕШЕНИЕ ПРОБЛЕМ

### Ошибка: "npm ci failed"
**Причина:** package-lock.json устарел

**Решение:**
```bash
npm install
git add package-lock.json
git commit -m "Update package-lock.json"
git push
```

### Ошибка: "electron-builder failed"
**Причина:** Проблема с сборкой Electron

**Решение:**
1. Проверь что в package.json правильная конфигурация
2. Проверь что есть файл electron/main.js
3. Напиши мне — разберёмся

### Workflow не запускается
**Причина:** Файл не в правильном месте

**Решение:**
Проверь путь: `.github/workflows/build-windows.yml`

---

## 📊 СРАВНЕНИЕ ВАРИАНТОВ

| Вариант | Интернет | Время | Сложность |
|---|---|---|---|
| GitHub Actions | Не нужен | 10 мин | Легко ✅ |
| Docker на Mac | Не нужен | 15 мин | Средне |
| Windows с инетом | Нужен | 15 мин | Легко |
| Offline npm | Не нужен | 30 мин | Сложно |

---

## ✅ ЧЕКЛИСТ

- [ ] Создан файл `.github/workflows/build-windows.yml`
- [ ] Запушен на GitHub
- [ ] Открыта вкладка Actions
- [ ] Запущен workflow вручную
- [ ] Дождался зелёного статуса
- [ ] Скачал windows-executables.zip
- [ ] Перенёс на Windows

---

**Готово!** 🎉

Если возникнут вопросы — пиши!
