nurdamiron/rams-projects/firmware/esp32/SHOPPING-LIST.md

# Список компонентов для покупки - RAMS Interactive Hub

## 📋 Что нужно купить

### 1. Основные компоненты

| № | Компонент | Кол-во | Цена (примерно) | Где купить | Примечание |
|---|---|---|---|---|---|
| 1 | **ESP32 DevKit V1** | 1 шт | $5-10 | AliExpress, Amazon | Любая версия с WiFi |
| 2 | **WS2812B LED лента 12V** | 5-10м | $15-30/5м | AliExpress | Уточнить плотность: 30/60 LED/м |
| 3 | **Блок питания 12V 10A** | 1 шт | $15-25 | AliExpress, местные | Минимум 120W |
| 4 | **USB БП 5V 2A** | 1 шт | $3-5 | Любой | Для ESP32 |
| 5 | **Relay Module 4-channel** | 1 шт | $3-5 | AliExpress | 5V logic, 12V/10A |
| 6 | **L298N H-Bridge** | 1 шт | $3-5 | AliExpress | Для актуаторов |
| 7 | **Level Shifter 74HCT125** | 1 шт | $2-3 | AliExpress | Или готовый модуль |
| 8 | **Linear Actuator 12V** | 1-3 шт | $20-50/шт | AliExpress | Длина хода: 50-200мм |

**Итого основное**: ~$100-150

---

### 2. Электронные компоненты

| № | Компонент | Кол-во | Примечание |
|---|---|---|---|
| 9 | Конденсатор 1000μF 25V | 2 шт | Электролитический |
| 10 | Резистор 470Ω | 1 шт | 1/4W (опционально для Data) |
| 11 | Предохранители 5A | 2 шт | Для линий 12V |
| 12 | Предохранители 10A | 1 шт | Для основного питания |
| 13 | Держатели предохранителей | 3 шт | Врезные или на панель |
| 14 | Диоды 1N4007 | 4 шт | Защита от обратного тока |
| 15 | Клеммники винтовые | 10 шт | 2-3 контакта |

**Итого электроника**: ~$10-15

---

### 3. Провода и кабели

| № | Компонент | Длина | Примечание |
|---|---|---|---|
| 16 | Провод 1.5мм² красный | 5м | Для +12V |
| 17 | Провод 1.5мм² черный | 5м | Для GND |
| 18 | Провод 0.75мм² зеленый | 3м | Для Data/Signal |
| 19 | Dupont кабели M-M | 20 шт | Для GPIO соединений |
| 20 | Dupont кабели M-F | 20 шт | Для подключения к модулям |
| 21 | USB кабель Micro-USB | 1 шт | Для ESP32 |

**Итого провода**: ~$10-15

---

### 4. Крепеж и монтаж

| № | Компонент | Кол-во | Примечание |
|---|---|---|---|
| 22 | DIN-рейка 35мм | 1м | Для монтажа компонентов |
| 23 | Крепления для DIN-рейки | 10 шт | Для модулей |
| 24 | Пластиковый корпус | 1 шт | Для ESP32 (опционально) |
| 25 | Распределительная коробка | 1 шт | Для проводов |
| 26 | Стяжки кабельные | 50 шт | Для организации проводов |
| 27 | Изолента | 1 рулон | |
| 28 | Термоусадка | набор | Для изоляции соединений |

**Итого крепеж**: ~$15-20

---

### 5. Инструменты (если нет)

| № | Инструмент | Примечание |
|---|---|---|
| 29 | Паяльник 40W | Для пайки проводов |
| 30 | Припой | Канифольный |
| 31 | Мультиметр | Для измерения напряжения/тока |
| 32 | Кусачки | Для обрезки проводов |
| 33 | Стриппер | Для зачистки изоляции |
| 34 | Отвертки (крестовая, плоская) | Для клеммников |
| 35 | Термопистолет | Для термоусадки (опционально) |

**Если уже есть**: $0, если покупать: ~$30-50

---

## 🛒 Где покупать

### Онлайн магазины

1. **AliExpress** (дешево, но долго - 2-4 недели):
   - ESP32 DevKit
   - WS2812B LED ленты
   - Реле модули
   - H-Bridge L298N
   - Актуаторы

2. **Amazon** (быстро, но дороже):
   - Блоки питания
   - Готовые наборы компонентов
   - Level Shifter модули

3. **Местные магазины электроники**:
   - Провода
   - Предохранители
   - Клеммники
   - Инструменты

---

## 📦 Готовые наборы

### Вариант A: Starter Kit

**Что включено**:
- ESP32 DevKit
- 5м WS2812B 12V (150 LED)
- БП 12V 5A
- Relay Module 2-channel
- Level Shifter
- Провода Dupont

**Цена**: ~$50-70
**Ссылка**: Искать "ESP32 LED Strip Kit" на AliExpress/Amazon

### Вариант B: Professional Kit

**Что включено**:
- ESP32 DevKit
- 10м WS2812B 12V (300 LED)
- БП 12V 10A
- Relay Module 4-channel
- L298N H-Bridge
- 2x Linear Actuator
- Level Shifter
- Все провода и крепеж

**Цена**: ~$150-200

---

## 🔍 Спецификации компонентов

### ESP32 DevKit

```
Характеристики:
✓ WiFi 802.11 b/g/n
✓ Bluetooth 4.2
✓ 34 GPIO pins
✓ 3.3V логика
✓ Flash: 4MB
✓ RAM: 520KB
✓ Частота: 240MHz

Рекомендуемая модель:
- ESP32-WROOM-32
- ESP32 DevKit V1
```

### WS2812B LED 12V

```
Характеристики:
✓ Напряжение: DC 12V
✓ Тип: 3 LED на 1 IC (WS2811)
✓ Плотность: 30/60 LED на метр
✓ Мощность: 0.24W на сегмент (3 LED)
✓ Цвета: RGB (16.7 млн цветов)
✓ IP rating: IP30 (внутри), IP65 (влагостойкая)

Рекомендуемая плотность:
- 60 LED/м для макетов (ярче)
- 30 LED/м для больших установок (дешевле)
```

### Блок питания 12V

```
Характеристики:
✓ Вход: AC 110-240V
✓ Выход: DC 12V
✓ Мощность: 120W (10A)
✓ Защиты: от перегрузки, КЗ, перегрева
✓ Регулировка: 11-13V (подстроечный резистор)
✓ Охлаждение: Вентилятор (для >100W)

Типы:
- Импульсный (switching) - рекомендуется
- Трансформаторный - тяжелый, но надежный
```

### Relay Module

```
Характеристики:
✓ Управление: 5V логика (совместима с 3.3V)
✓ Коммутация: 12V / 10A (AC или DC)
✓ Тип: Активный LOW
✓ Оптоизоляция: Да
✓ Индикация: LED на каждом канале

Каналы:
- 1-channel: для простых задач
- 4-channel: рекомендуется (резерв)
```

### L298N H-Bridge

```
Характеристики:
✓ Входное напряжение: 5-35V DC
✓ Ток на канал: 2A (пик 3A)
✓ Логика: 5V (совместима с 3.3V)
✓ Каналы: 2 (для 2 моторов)
✓ Защита: Диоды обратного тока

Для актуаторов:
- Канал A: Актуатор 1
- Канал B: Актуатор 2 (или резерв)
```

### Linear Actuator

```
Характеристики:
✓ Напряжение: 12V DC
✓ Ход: 50-200мм (выбрать по макету)
✓ Сила: 100-200N (10-20кг)
✓ Скорость: 5-20мм/с
✓ Ток: 2-5A (зависит от нагрузки)

Рекомендуемые модели:
- Actuonix L12
- Firgelli FA-PO-35-12-xx
- Generic 12V Linear Actuator (AliExpress)
```

---

## 💡 Рекомендации по выбору

### Для маленького макета (1-2 проекта)

```
- 3м WS2812B 12V (90 LED)
- БП 12V 3A
- Relay 2-channel
- 1x Actuator (опционально)

Цена: ~$50-70
```

### Для среднего макета (5-10 проектов)

```
- 5-7м WS2812B 12V (150-210 LED)
- БП 12V 5A
- Relay 4-channel
- L298N + 2x Actuator

Цена: ~$100-130
```

### Для большого макета (20+ проектов)

```
- 10-15м WS2812B 12V (300-450 LED)
- БП 12V 10A (или 2x 5A)
- Relay 8-channel (2x 4-channel)
- 2x L298N + 3-4x Actuator
- 2x ESP32 (для распределения нагрузки)

Цена: ~$200-300
```

---

## 📝 Чек-лист перед покупкой

### Измерения макета

- [ ] Длина LED лент: _____ метров
- [ ] Количество проектов: _____ шт
- [ ] Количество актуаторов: _____ шт
- [ ] Количество 12V ламп/вентиляторов: _____ шт
- [ ] Максимальное расстояние ESP32 → LED: _____ метров

### Расчет мощности

```
LED: _____ метров × 60 LED/м ÷ 3 × 0.24W = _____ W
Актуаторы: _____ шт × 30W (в среднем) = _____ W
Реле нагрузка: _____ шт × _____ W = _____ W

ИТОГО: _____ W

Блок питания: _____ W × 1.3 (запас 30%) = _____ W
Рекомендуемый БП: _____ V / _____ A
```

### Бюджет

```
Основные компоненты:     $______
Электроника:             $______
Провода и крепеж:        $______
Инструменты (если нужны): $______
Доставка:                $______

ИТОГО:                   $______
```

---

## 🚀 Быстрый старт (минимальный набор)

**Для первого теста (без покупки всего)**:

1. ✅ ESP32 DevKit ($7)
2. ✅ 1 метр WS2812B 12V ($3)
3. ✅ БП 12V 2A ($5) - или использовать имеющийся
4. ✅ Level Shifter ($2)
5. ✅ Провода Dupont ($2)

**ИТОГО**: ~$20

Этого хватит чтобы:
- Загрузить прошивку
- Протестировать LED
- Убедиться что все работает
- Потом докупить остальное

---

## 📞 Контакты продавцов (примеры)

### AliExpress Stores

- **BTF-LIGHTING Official Store** - WS2812B LED ленты
- **Great Wall Electronics** - ESP32, реле, модули
- **DIY More** - Актуаторы, моторы

### Amazon

- **ALITOVE** - LED ленты, блоки питания
- **HiLetgo** - ESP32, модули
- **Gikfun** - Электронные компоненты

---

**Дата**: 2026-01-27
**Версия**: 1.0
**Для проекта**: RAMS Interactive Hub

**Следующий шаг**: После покупки см. `WIRING-12V.md` для подключения
