nurdamiron/rams-projects/firmware/arduino_mega/INSTRUCTIONS.md

# Arduino Mega - Инструкции по прошивке

## 🎯 Финальная рабочая прошивка

**Директория:** `actuator_mega1_FINAL_WORKING/`

**Файл:** `actuator_mega1_FINAL_WORKING.ino`

**Статус:** ✅ ПРОТЕСТИРОВАНО И РАБОТАЕТ (15.02.2026)

### Быстрая загрузка:

```bash
cd rams-interactive-hub/firmware/arduino_mega

# Компиляция и загрузка
arduino-cli compile --fqbn arduino:avr:mega:cpu=atmega2560 actuator_mega1_FINAL_WORKING
arduino-cli upload -p /dev/cu.usbmodem141021 --fqbn arduino:avr:mega:cpu=atmega2560 actuator_mega1_FINAL_WORKING

# Мониторинг
arduino-cli monitor -p /dev/cu.usbmodem141021 -c baudrate=115200
```

### Что делает:

- Управляет 8 блоками актуаторов (16 актуаторов всего)
- Цикл 90 секунд: Block 1 UP → 1 DOWN + 2 UP → ... → 8 DOWN
- Инверсная логика реле (LOW = ON)
- Каждый этап = 10 секунд

### ⚠️ Важно:

- Блоки 6,7,8 имеют нестандартный маппинг пинов (см. README)
- Требуется отдельное питание 12V/24V для актуаторов
- НЕ ИЗМЕНЯТЬ без веской причины!

---

## 📁 Другие прошивки

### Тестовые прошивки (для отладки):

- `test_one_pin/` - тест одного пина
- `test_block8_both/` - тест Block 8 (оба актуатора)
- `test_all_blocks_correct/` - тест всех блоков по очереди
- `test_together_simple/` - простой тест одновременной работы

### Использование тестовых прошивок:

Только для отладки! Используй `actuator_mega1_FINAL_WORKING` для продакшена.

---

**Дата:** 15 февраля 2026
**Автор:** Claude Code
**Версия:** 1.0
