nurdamiron/rams-projects/firmware/PRODUCTION_v3.2_FINAL/WIFI_SETUP.md

# WiFi Setup Guide - RAMS Controller v3.2

**Дата:** 2026-02-16
**Версия:** 3.2 Station Mode

---

## 📡 Архитектура сети

```
Rams_WIFI Router (192.168.X.1)
    ├─ Windows PC (192.168.X.10)
    │   ├─ RAMS Interactive Hub App → ESP32
    │   └─ Video Casting → Smart TV
    │
    ├─ ESP32 (192.168.X.XXX) ← получает динамический IP
    │   └─ Serial → Mega #1 + Mega #2 → Actuators + LEDs
    │
    └─ Smart TV (192.168.X.50)
```

**Все устройства в одной сети = всё работает!** ✅

---

## 🔧 Шаг 1: Прошивка ESP32

### Текущая конфигурация WiFi:
```cpp
#define WIFI_SSID   "Rams_WIFI"
#define WIFI_PASS   "Rams2021"
```

### Как прошить:

1. **Подключи ESP32 к компьютеру через USB**

2. **Найди порт:**
   ```bash
   ls /dev/cu.* | grep usb
   ```

3. **Прошей ESP32:**
   ```bash
   cd /Users/nurdauletakhmatov/Desktop/rams-screen/rams-interactive-hub/firmware/esp32/rams_controller_v3

   arduino-cli upload -p /dev/cu.XXXXX --fqbn esp32:esp32:esp32 .
   ```
   (Замени `/dev/cu.XXXXX` на реальный порт)

4. **Открой Serial Monitor:**
   ```bash
   arduino-cli monitor -p /dev/cu.XXXXX -c baudrate=115200
   ```

---

## 📝 Шаг 2: Узнай IP адрес ESP32

После прошивки ESP32 покажет в Serial Monitor:

```
[WIFI] Connecting to Rams_WIFI...
..........
[WIFI] ✅ Connected to Rams_WIFI!
[WIFI] IP Address: 192.168.X.XXX  ⬅️ ЗАПИШИ ЭТОТ IP!
[WIFI] Gateway: 192.168.X.1
[WIFI] Signal: -45 dBm
```

**Запиши IP адрес!** Например: `192.168.1.100`

---

## ⚙️ Шаг 3: Настрой приложение

### Вариант 1: Через .env.local (рекомендуется)

Отредактируй файл:
```
rams-interactive-hub/.env.local
```

Замени IP на тот который показал ESP32:
```env
NEXT_PUBLIC_ESP32_HOST=192.168.1.100  ⬅️ ВОТ СЮДА
NEXT_PUBLIC_ESP32_PORT=80
```

### Вариант 2: Прямо в коде

Отредактируй файл:
```
rams-interactive-hub/lib/esp32-client.ts
```

Найди функцию `createLocalESP32Client()` и замени:
```typescript
return new ESP32Client({
  host: "192.168.1.100",  // ⬅️ Твой IP
  port: 80,
  timeout: 5000,
});
```

---

## 🚀 Шаг 4: Перезапусти приложение

```bash
cd /Users/nurdauletakhmatov/Desktop/rams-screen/rams-interactive-hub/rams-interactive-hub

# Остановить (Ctrl+C если запущено)
# Запустить заново
npm run dev
```

---

## ✅ Проверка работы

### 1. Открой консоль браузера (F12)

Должны появиться логи:
```
[ESP32Client] Creating client for 192.168.1.100:80
[ProjectSync] Starting auto-connect to ESP32...
[ProjectSync] Pinging ESP32 at 192.168.1.100...
[ProjectSync] Connection status changed: ✅ ONLINE
```

### 2. Кликни на проект в галерее

Должны появиться логи:
```
[App] ========== PROJECT SELECT ==========
[ProjectSync] ============ ACTIVATION START ============
[ProjectSync] ESP32 Connected: true
[ProjectSync] Blocks to activate: [1, 2]
[ESP32Client] POST http://192.168.1.100/api/block?num=1&action=UP&duration=8000
[ESP32Client] ✅ Block 1 UP success
```

### 3. Проверь актуаторы и LED

Должны подняться актуаторы и загореться LED!

---

## 🔧 Изменить WiFi логин/пароль

Если нужно подключить ESP32 к другому WiFi:

1. Отредактируй файл:
   ```
   firmware/esp32/rams_controller_v3/rams_controller_v3.ino
   ```

2. Найди строки:
   ```cpp
   #define WIFI_SSID   "Rams_WIFI"
   #define WIFI_PASS   "Rams2021"
   ```

3. Замени на новые:
   ```cpp
   #define WIFI_SSID   "Новое_Имя_WiFi"
   #define WIFI_PASS   "Новый_Пароль"
   ```

4. Прошей ESP32 заново (см. Шаг 1)

---

## 🛡️ Резервный режим (AP Mode)

Если ESP32 НЕ сможет подключиться к `Rams_WIFI`, он автоматически создаст свою сеть:

```
SSID: RAMS_Controller
Password: rams2026
IP: 192.168.4.1
```

В этом случае:
- Windows должен подключиться к `RAMS_Controller`
- Приложение будет работать
- НО видео на TV работать НЕ будет (нет интернета)

---

## 🐛 Troubleshooting

### ESP32 не подключается к Rams_WIFI

**Проверь:**
1. WiFi роутер включен
2. SSID и пароль правильные
3. ESP32 находится в зоне покрытия WiFi
4. Роутер не блокирует новые устройства (MAC фильтр)

**Логи в Serial Monitor:**
```
[WIFI] Connecting to Rams_WIFI...
....................
[WIFI] ❌ Failed to connect to Rams_WIFI
[WIFI] Starting AP Mode (backup)...
```

### Приложение не видит ESP32

**Проверь:**
1. Windows подключен к **Rams_WIFI** (не к RAMS_Controller!)
2. IP адрес в `.env.local` правильный
3. ESP32 включен и подключен к WiFi
4. Ping ESP32 из терминала:
   ```bash
   ping 192.168.1.100
   ```

### Видео не передается на TV

**Проверь:**
1. Windows подключен к **Rams_WIFI**
2. TV подключен к **Rams_WIFI**
3. Chromecast/AirPlay настроен
4. Не используешь RAMS_Controller AP Mode

---

## 📊 Статус индикация в приложении

В галерее проектов появится индикатор подключения ESP32:

- 🟢 **Online** - ESP32 подключен, все работает
- 🔴 **Offline** - ESP32 не отвечает
- 🟡 **Warning** - Слабое соединение

---

## 🎉 Готово!

Теперь у тебя:
- ✅ Windows подключен к Rams_WIFI (интернет есть)
- ✅ ESP32 подключен к Rams_WIFI (управление актуаторами)
- ✅ TV подключен к Rams_WIFI (видео работает)
- ✅ Всё в одной сети!
