nurdamiron/rams-projects/firmware/arduino_mega/test_scripts/MEGA1_TEST_GUIDE.md

# Тестирование Mega #1 (Блоки 1-8)

## 📋 Подготовка

1. **Загрузи прошивку** `actuator_mega1/actuator_mega1.ino` на Arduino Mega #1
2. **Подключи USB** от Mega к компьютеру
3. **Открой Serial Monitor** в Arduino IDE:
   - Tools → Serial Monitor
   - Установи baud rate: **115200**
   - Line ending: **Newline**

## ✅ Проверка инициализации

После подключения ты должен увидеть:

```
========================================
  RAMS MEGA #1 ACTUATOR CONTROLLER
  Blocks 1-8 (16 Actuators)
  Arduino Mega - Pins 22-53
  INVERSE LOGIC (LOW=ON, HIGH=OFF)
  Serial1 (TX1=18, RX1=19) ↔ ESP32
========================================

[INIT] 32 pins (22-53) initialized (all OFF)
[INIT] 8 blocks ready
[INIT] Serial1 ready for ESP32 commands

[READY] Waiting for commands from ESP32...
========================================
```

✅ Если видишь это - **инициализация прошла успешно!**

---

## 🧪 Тест 1: Блок 1 ВВЕРХ (5 секунд)

**Команда в Serial Monitor:**
```json
{"block":1,"action":"up","duration":5000}
```

**Ожидаемый результат:**
```
[CMD] Received: {"block":1,"action":"up","duration":5000}
[BLOCK 1] → UP (5000ms, 2 actuators)
```

**Что должно произойти:**
- Пины 22, 24 → LOW (включены)
- Пины 23, 25 → HIGH (выключены)
- Через 5 секунд:
```
[AUTO-STOP] Block 1
```

✅ **Проверь:** актуаторы блока 1 должны двигаться вверх 5 секунд и остановиться

---

## 🧪 Тест 2: Блок 1 ВНИЗ (5 секунд)

**Команда:**
```json
{"block":1,"action":"down","duration":5000}
```

**Ожидаемый результат:**
```
[CMD] Received: {"block":1,"action":"down","duration":5000}
[BLOCK 1] → DOWN (5000ms, 2 actuators)
[AUTO-STOP] Block 1
```

**Что должно произойти:**
- Пины 22, 24 → HIGH (выключены)
- Пины 23, 25 → LOW (включены)
- Через 5 секунд автостоп

✅ **Проверь:** актуаторы блока 1 должны двигаться вниз 5 секунд

---

## 🧪 Тест 3: Ручная остановка блока

**Команда 1 - запусти вверх:**
```json
{"block":1,"action":"up","duration":30000}
```

**Подожди 2 секунды, затем команда 2 - останови:**
```json
{"block":1,"action":"stop"}
```

**Ожидаемый результат:**
```
[BLOCK 1] → UP (30000ms, 2 actuators)
[BLOCK 1] → STOP
```

✅ **Проверь:** блок останавливается немедленно по команде stop

---

## 🧪 Тест 4: Блок 8 (последний блок)

**Команда:**
```json
{"block":8,"action":"up","duration":5000}
```

**Ожидаемый результат:**
```
[CMD] Received: {"block":8,"action":"up","duration":5000}
[BLOCK 8] → UP (5000ms, 2 actuators)
[AUTO-STOP] Block 8
```

**Пины:**
- 46, 48 → LOW
- 47, 49 → HIGH

✅ **Проверь:** блок 8 (пины 46-49) работает корректно

---

## 🧪 Тест 5: Остановить ВСЕ блоки

**Команда 1 - запусти несколько блоков:**
```json
{"block":1,"action":"up","duration":30000}
```
```json
{"block":3,"action":"down","duration":30000}
```
```json
{"block":5,"action":"up","duration":30000}
```

**Команда 2 - останови все:**
```json
{"block":0,"action":"stop"}
```

**Ожидаемый результат:**
```
[CMD] STOP ALL BLOCKS
[SYSTEM] All blocks stopped
```

✅ **Проверь:** ВСЕ блоки останавливаются одновременно

---

## 🧪 Тест 6: Проверка диапазона блоков

**Команда (неверный блок для Mega #1):**
```json
{"block":9,"action":"up","duration":5000}
```

**Ожидаемый результат:**
```
[CMD] Received: {"block":9,"action":"up","duration":5000}
[ERROR] Invalid block number: 9
```

✅ **Проверь:** Mega #1 отклоняет блоки 9-15 (это блоки Mega #2)

---

## 🧪 Тест 7: Одновременная работа нескольких блоков

**Команда 1:**
```json
{"block":1,"action":"up","duration":10000}
```

**Команда 2 (через 1 секунду):**
```json
{"block":2,"action":"down","duration":10000}
```

**Команда 3 (через 2 секунды):**
```json
{"block":3,"action":"up","duration":10000}
```

**Ожидаемый результат:**
```
[BLOCK 1] → UP (10000ms, 2 actuators)
[BLOCK 2] → DOWN (10000ms, 2 actuators)
[BLOCK 3] → UP (10000ms, 2 actuators)
[AUTO-STOP] Block 1
[AUTO-STOP] Block 2
[AUTO-STOP] Block 3
```

✅ **Проверь:** Все блоки работают независимо и останавливаются по своим таймерам

---

## 🧪 Тест 8: Полный цикл всех блоков (по очереди)

**Скопируй и отправляй по очереди с паузой 5 секунд:**

```json
{"block":1,"action":"up","duration":3000}
```
```json
{"block":2,"action":"up","duration":3000}
```
```json
{"block":3,"action":"up","duration":3000}
```
```json
{"block":4,"action":"up","duration":3000}
```
```json
{"block":5,"action":"up","duration":3000}
```
```json
{"block":6,"action":"up","duration":3000}
```
```json
{"block":7,"action":"up","duration":3000}
```
```json
{"block":8,"action":"up","duration":3000}
```

✅ **Проверь:** Каждый блок (1-8) поднимается на 3 секунды и останавливается

---

## 🔧 Маппинг пинов для физической проверки

| Блок | Pin 1 | Pin 2 | Pin 3 | Pin 4 | Примечание |
|---|---|---|---|---|---|
| 1 | 22 | 23 | 24 | 25 | Стандартный |
| 2 | 26 | 27 | 28 | 29 | Стандартный |
| 3 | 30 | 31 | 32 | 33 | Стандартный |
| 4 | 34 | 35 | 36 | 37 | Стандартный |
| 5 | 38 | 39 | 40 | 41 | Стандартный |
| 6 | 50 | 51 | 52 | 53 | **ФИЗИЧЕСКИ ЗАПАЯН** |
| 7 | 42 | 43 | 44 | 45 | Стандартный |
| 8 | 46 | 47 | 48 | 49 | Стандартный |

**Проверка пинов мультиметром:**
- **UP:** Pin1=LOW (~0V), Pin2=HIGH (~5V), Pin3=LOW, Pin4=HIGH
- **DOWN:** Pin1=HIGH (~5V), Pin2=LOW (~0V), Pin3=HIGH, Pin4=LOW
- **STOP:** Все пины HIGH (~5V)

---

## ⚠️ Проблемы и решения

### Проблема: Не видно вывода в Serial Monitor
**Решение:**
- Проверь baud rate (должно быть 115200)
- Проверь выбранный COM порт
- Перезагрузи Arduino (кнопка RESET)

### Проблема: Команды не выполняются
**Решение:**
- Проверь формат JSON (правильные кавычки)
- Убедись что Line ending = "Newline"
- Проверь что команда полностью скопирована

### Проблема: Блоки не останавливаются автоматически
**Решение:**
- Проверь что в loop() вызывается checkBlockTimers()
- Перепрошей Mega заново

### Проблема: Актуаторы двигаются в обратную сторону
**Решение:**
- Это нормально - проверь физическое подключение актуаторов
- Возможно нужно поменять провода местами на актуаторе

---

## ✅ Контрольный список тестирования

- [ ] Инициализация успешна (вывод при старте)
- [ ] Блок 1 движется ВВЕРХ
- [ ] Блок 1 движется ВНИЗ
- [ ] Ручная остановка работает
- [ ] Автоостановка по таймеру работает
- [ ] Блок 8 работает
- [ ] Команда "stop all" (block=0) работает
- [ ] Mega #1 отклоняет блоки 9-15
- [ ] Несколько блоков работают одновременно
- [ ] Все 8 блоков проверены по очереди

---

## 🚀 Следующие шаги

Когда все тесты пройдены:
1. ✅ Mega #1 работает корректно
2. ⏭️ Загрузить прошивку на Mega #2
3. ⏭️ Протестировать Mega #2 (блоки 9-15)
4. ⏭️ Подключить обе Mega к ESP32
5. ⏭️ Тестировать через ESP32 и приложение

---

**Готов к тестированию! Удачи! 🔥**
