nurdamiron/rams-projects/BUILD_ON_WINDOWS.md

# 🚀 КАК СОБРАТЬ ПРИЛОЖЕНИЕ НА WINDOWS

## ❗ ВАЖНО
На **Mac нельзя собрать Windows .exe** файлы! Нужно собирать на Windows машине.

---

## 📦 ЧТО ОТПРАВИТЬ НА WINDOWS

Отправь **ВЕСЬ проект** на Windows компьютер. Можно:
- Через флешку
- Через облако (Google Drive / Dropbox)
- Через git clone

**Путь к проекту:**
```
/Users/nurdauletakhmatov/Desktop/rams-screen/rams-interactive-hub/
```

---

## 🔧 ЧТО НУЖНО НА WINDOWS

1. **Node.js 20+**
   - Скачать: https://nodejs.org/
   - Установить с настройками по умолчанию

2. **Git** (если будешь клонировать)
   - Скачать: https://git-scm.com/download/win

---

## 📝 ИНСТРУКЦИЯ ДЛЯ WINDOWS (ШАГ ЗА ШАГОМ)

### Шаг 1: Копируем проект

**Вариант A: Через флешку/облако**
```
1. Скопируй папку rams-interactive-hub на Windows
2. Размести её например в C:\Projects\rams-interactive-hub
```

**Вариант B: Через Git**
```cmd
git clone https://github.com/nurdamiron/rams-projects.git rams-interactive-hub
cd rams-interactive-hub
```

---

### Шаг 2: Открой командную строку (CMD или PowerShell)

```cmd
# Перейди в папку проекта
cd C:\Projects\rams-interactive-hub

# ИЛИ используй полный путь где ты скопировал
```

---

### Шаг 3: Установи зависимости

```cmd
npm install
```

⏱️ Займёт **5-10 минут** (скачается ~1 GB)

---

### Шаг 4: Собери приложение

```cmd
npm run electron:build
```

⏱️ Займёт **3-5 минут**

---

### Шаг 5: Найди готовые файлы

После сборки файлы будут в папке:
```
dist/
├── RAMS Interactive Hub Setup 0.1.0.exe    (Установщик)
└── RAMS-Interactive-Hub-Portable.exe       (Портативная версия)
```

---

## ✅ ЧТО ПОЛУЧИТСЯ

- **Setup .exe** (~300 MB) - установщик с автозапуском
- **Portable .exe** (~300 MB) - запуск без установки

**БЕЗ медиа-файлов внутри!** (как и планировали)

---

## 📂 ПОЛНАЯ СТРУКТУРА ДЛЯ РАЗВЕРТЫВАНИЯ

После сборки нужно:

```
1. Скопировать dist/RAMS-Interactive-Hub-Portable.exe
2. Создать рядом папку media/projects/
3. Положить туда все фото и видео проектов
```

**Итоговая структура на киоске:**
```
C:\RAMS\
├── RAMS-Interactive-Hub-Portable.exe   ← Приложение
└── media\
    └── projects\
        ├── 01-rams-beyond-st-regis\
        ├── 02-rams-city\
        └── ... (все проекты)
```

---

## 🐛 РЕШЕНИЕ ПРОБЛЕМ

### "npm: command not found"
**Решение:** Node.js не установлен или не в PATH
```cmd
# Проверь:
node -v
npm -v

# Если не работает - переустанови Node.js
```

### "Error: Cannot find module..."
**Решение:** npm install не выполнился полностью
```cmd
# Удали node_modules и попробуй снова:
rmdir /s node_modules
npm install
```

### "electron-builder failed"
**Решение:** Недостаточно прав или антивирус блокирует
```cmd
# Запусти CMD от имени администратора
# Или добавь папку в исключения антивируса
```

### Сборка зависает
**Решение:** Проверь свободное место на диске
- Нужно минимум **5 GB** свободного места
- Проверь: `Этот компьютер → Диск C:`

---

## 🎯 ИТОГОВЫЙ ЧЕКЛИСТ

- [ ] Node.js 20+ установлен
- [ ] Проект скопирован на Windows
- [ ] `npm install` выполнен без ошибок
- [ ] `npm run electron:build` завершился успешно
- [ ] Файлы .exe появились в `dist/`
- [ ] Проверил что .exe запускается (можно без медиа)

---

## 💡 АЛЬТЕРНАТИВА: Собрать в облаке

Если нет доступа к Windows машине, можно использовать:
- **GitHub Actions** (CI/CD) - бесплатно
- **AppVeyor** - бесплатно для open-source
- **Windows VM** на облаке (Azure, AWS)

Но это сложнее, лучше просто на реальном Windows собрать! 😊

---

## 📞 ПОМОЩЬ

Если что-то не получается:
1. Сделай скриншот ошибки
2. Пришли текст ошибки
3. Напиши на каком шаге застрял

**Удачи!** 🚀
