nurdamiron/rams-projects/firmware/OTA_FIX_GUIDE.md

# OTA FIRMWARE UPDATE FIX

## Problem Summary

OTA (Over-The-Air) firmware updates were not working because:
1. **Missing `#include <ESPmDNS.h>`** - mDNS library was not included
2. **No `MDNS.begin()` call** - mDNS service was never initialized
3. **Port 3232 not open** - ArduinoOTA requires mDNS to open the OTA port

## Solution Applied

### Changes to `rams_controller_v3.ino`:

1. **Added mDNS library** (line 31):
   ```cpp
   #include <ESPmDNS.h>
   ```

2. **Added mDNS initialization** (lines 621-629):
   ```cpp
   // ===== mDNS SETUP =====
   if (MDNS.begin(OTA_HOSTNAME)) {
     Serial.println("[mDNS] Responder started");
     Serial.printf("[mDNS] Hostname: %s.local\n", OTA_HOSTNAME);
     MDNS.addService("http", "tcp", 80);  // Advertise HTTP service
     Serial.println("[mDNS] HTTP service advertised");
   } else {
     Serial.println("[mDNS] ⚠️ Failed to start! OTA will not work.");
   }
   ```

3. **Updated `.env.local`** - Changed ESP32 IP from `192.168.4.1` (AP mode) to `192.168.110.65` (current router IP)

## Current ESP32 Status

- **IP Address**: `192.168.110.65` (connected to Rams_WIFI)
- **Hostname**: `RAMS-ESP32.local`
- **Web Server**: ✅ Working on port 80
- **OTA Port**: ❌ Not yet active (need to upload fixed firmware first)

## How to Upload Fixed Firmware

### Option 1: USB Upload (Recommended for first fix)

```bash
cd /Users/nurdauletakhmatov/Desktop/rams-screen/rams-interactive-hub/firmware/PRODUCTION_v3.2_FINAL/esp32

# Upload via USB
pio run -e esp32_production -t upload
```

### Option 2: OTA Upload (after first fix is uploaded via USB)

```bash
cd /Users/nurdauletakhmatov/Desktop/rams-screen/rams-interactive-hub/firmware/PRODUCTION_v3.2_FINAL/esp32

# Upload via WiFi (OTA)
pio run -e esp32_ota -t upload --upload-port 192.168.110.65
# Password: rams2026
```

### Option 3: Using mDNS hostname (after first fix)

```bash
pio run -e esp32_ota -t upload --upload-port RAMS-ESP32.local
# Password: rams2026
```

## Verification Steps

After uploading the fixed firmware:

1. **Check Serial Monitor** - should see:
   ```
   [mDNS] Responder started
   [mDNS] Hostname: RAMS-ESP32.local
   [mDNS] HTTP service advertised
   [OTA] Update service started
   [OTA] Hostname: RAMS-ESP32 | Password: rams2026
   ```

2. **Test OTA port**:
   ```bash
   nc -zv 192.168.110.65 3232
   # Should show: Connection to 192.168.110.65 port 3232 [tcp/*] succeeded!
   ```

3. **Test mDNS**:
   ```bash
   ping RAMS-ESP32.local
   # Should respond from 192.168.110.65
   ```

## OTA Configuration Reference

- **Port**: `3232`
- **Password**: `rams2026`
- **Hostname**: `RAMS-ESP32`
- **mDNS Name**: `RAMS-ESP32.local`

## Important Notes

1. **OTA only works in STATION mode** (connected to router), NOT in AP mode
2. **mDNS is required** for ArduinoOTA to function
3. **Both devices must be on the same WiFi network** (Rams_WIFI)
4. **First fix must be uploaded via USB** - subsequent updates can use OTA
5. **Safety feature**: OTA automatically stops all actuators before updating

## Troubleshooting

### If OTA still doesn't work after fix:

1. Check ESP32 is connected to Rams_WIFI (not AP mode):
   ```bash
   ping RAMS-ESP32.local
   ```

2. Check port 3232 is open:
   ```bash
   nc -zv 192.168.110.65 3232
   ```

3. Check Serial Monitor for mDNS errors

4. Try using IP address instead of hostname:
   ```bash
   pio run -e esp32_ota -t upload --upload-port 192.168.110.65
   ```

5. Check firewall settings on Mac - port 3232 must be allowed

## Next Steps

1. Upload the fixed firmware via USB
2. Verify OTA port 3232 is open
3. Test OTA update with a small change
4. Update documentation with OTA workflow
