nurdamiron/rams-projects/(commit log)

2026-01-27 Complete localization for all UI components (v1.0 design)
    - Add full translations for 28 projects in 4 languages (RU, KK, TR, EN)
    - Localize all UI components: info-modal, screensaver, error-boundary, admin page
    - Add quarter, location, and measurement unit translations
    - Add helper functions: getLocalizedQuarter, getLocalizedLocation, getLocalizedCeilingHeight, getLocalizedDistance
    - Fix hardcoded Russian text in layout.tsx metadata
    - Update ceiling heights and distances to use localized units (м/m, км/km)
2026-01-27 Fix: Include fonts in Electron build to fix icon display
    ISSUE:
    - Icons showing as text instead of symbols
    - Material Symbols font not loading in Windows .exe
    CAUSE:
    - public/fonts/**/* was not included in electron-builder files config
    - Font file exists at public/fonts/material-symbols-outlined.woff2
    - But wasn't being packaged into the .exe
    FIX:
    - Added "public/fonts/**/*" to build.files array in package.json
    - Now Material Symbols font will be included in the build
    - Icons will display correctly as symbols instead of text
2026-01-28 Redesign UI: new gallery layout, project detail page, animations
    - New 5x3 grid gallery with logo-based cards (15 projects)
    - Split layout for project details (logo+info | gallery)
    - Added smooth page transitions and animations
    - Compact icon buttons in header
    - Professional pulse effect on video button
    - Fixed project name translations (keep original brand names)
    - Enhanced About Company modal design
2026-01-28 Update font loading and package metadata
    - Switch Material Symbols to Google Fonts CDN for better reliability
    - Bump version to 2.0.0
    - Add project description and author
2026-02-08 Refactor UI components, add firmware layer, and update build pipeline
    - Rework gallery, project hub, and admin modal components
    - Remove unused hardware API routes and serial lib
    - Add ESP32/Mega firmware with master-relay architecture
    - Replace Windows-only workflow with cross-platform build
    - Add deployment documentation
    [main.cpp, protocol.h]
2026-02-09 Add ESP32 UDP hardware control with configurable block mapping
    Implement full UDP communication pipeline for kinetic table control:
    - Electron main process UDP client (dgram) with debouncing and health checks
    - IPC bridge for renderer ↔ main process communication
    - Hardware service facade with project ID → block number resolution
    - Admin panel Hardware tab: ESP32 IP config, ping, emergency stop, LED modes
    - Configurable block mapping with persistence in hardware-config.json
    - Screensaver integration: reset blocks + rainbow LED on idle
    - Fix debounce Promise leak (reply was never sent)
2026-02-09 Add LG TV SSAP integration and fix Windows build targets
    - LG TV control via WebSocket SSAP protocol (ws://TV:3000)
    - HTTP media server in Electron (port 8888) to serve video to TV
    - Auto-pairing with client-key persistence in hardware-config.json
    - Video button sends to TV instead of playing locally
    - "Playing on TV" indicator with stop button
    - TV settings in admin panel: IP config, connect/disconnect
    - Auto-connect to TV on app start if configured
    - Range request support for video seeking on TV
    - Windows build: nsis installer + portable exe targets
    - Cleanup TV resources on app quit
2026-02-09 Add ESP32 and Arduino Mega communication firmware
    - Added Arduino Mega actuator controller with Serial JSON communication
    - Modified ESP32 firmware to send commands to Mega via Serial2
    - Implemented 8-block actuator control system (16 actuators total)
    - Added comprehensive documentation and quick start guides
    - Updated .gitignore to exclude large media files
2026-02-09 Add support for 3rd actuator in Block 8
    - Modified Block struct to support 2 or 3 actuators
    - Block 8 now uses 6 pins (46,47,48,49,2,3) for 3 actuators
    - Updated all control functions to handle variable actuator count
    - Added Arduino Mega README with full documentation
    - Total: 17 actuators (7×2 + 1×3)
2026-02-09 feat: Добавлены прошивки для двух Arduino Mega и ESP32
    - Mega #1: блоки 1-8 (16 актуаторов, пины 22-53)
    - Mega #2: блоки 9-15 (15 актуаторов, блок 15 имеет 3 актуатора)
    - ESP32: поддержка двух Serial линий (GPIO 16/17 для Mega #1, GPIO 25/26 для Mega #2)
    - Автоматическая маршрутизация команд по номеру блока
    - Тестовый гайд для Mega #1
    - Обновлённая документация с полной схемой подключения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
2026-02-09 refactor: Удалена старая прошивка actuator_test
    - Удалён actuator_test (заменён на actuator_mega1 и actuator_mega2)
    - Добавлен тестовый скрипт для проверки всех блоков Mega #2
2026-02-16 feat: Complete RAMS Interactive Hub v2.0 with ESP32 integration
    Major Updates:
    - Split-scroll ProjectHub layout (left: scrollable projects, right: fixed gallery)
    - Multi-project support for gallery cards
    - ESP32 + 2x Arduino MEGA integration for actuators and LED control
    - WebSocket-based hardware control
    - Production-ready firmware v3.2 for ESP32 and MEGA boards
    - Complete i18n support (RU/KK/EN/TR)
    - Actuator control panel UI
    - Project sync with LED effects
    - Gallery reordering (15 cards optimized layout)
    - Updated logos (Haval, RAMS RV, Ortau)
    Technical Details:
    - ESP32 WiFi AP (192.168.4.1)
    - Serial communication protocol between ESP32 and MEGAs
    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
    [ACTUATOR_CONFIG.h, actuator_mega1.ino, actuator_mega1_FINAL_WORKING.ino, actuator_mega1_simple.ino, actuator_mega1_v3.ino, actuator_mega2_FINAL_WORKING.ino, actuator_mega2_simple.ino, actuator_mega2_test.ino]
2026-02-17 Add full web control interface and emergency firmware for RAMS v3.2
    Major improvements:
    - ESP32: Full web UI with LED effects (Static, Pulse, Rainbow, Chase, Sparkle, Wave, Fire, Meteor)
    - ESP32: LED test mode to activate LEDs without moving actuators
    - ESP32: Brightness and speed sliders for real-time control
    - Mega 2: Emergency lower all firmware for safe system reset
    - Mega 2: Production firmware restore with proper ACTUATOR_CONFIG.h
    - All 15 blocks control with UP/DOWN/STOP buttons
    - Rainbow effect now works correctly with LED state management
    Technical changes:
    - Added /api/led-test endpoint for testing LEDs without actuator movement
    - Added ledStates[] array to track LED status indepe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
    [ACTUATOR_CONFIG.h, actuator_mega2_v3.ino, emergency_lower_all.ino, rams_controller_v3.ino]
2026-02-19 Fix project-to-block mapping + Add OTA support
    🐛 Fixed critical bugs:
    - Project activation bug: HYUNDAI, LUKOIL, ORTAU MARRIOTT BC didn't activate hardware blocks
    - Changed from array index-based to ID-based block lookup using gallery-config mapping
    - Multiple projects can now control the same block (e.g., HAVAL, HYUNDAI, LUKOIL all control Block 2)
    ⚡ Performance improvements:
    - Reduced animation timings: UP 6s→2s, DOWN 6s→3s, LED fade 3s→2s
    - Faster testing and better responsiveness
    🔧 ESP32 OTA firmware updates:
    - Added missing ESPmDNS library (#include <ESPmDNS.h>)
    - Added MDNS.begin() initialization before ArduinoOTA
    - OTA port 3232 will now open correctly after firmware u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
    [ACTUATOR_CONFIG.h, rams_controller_v3.ino]
2026-02-19 Add Control Panel + Fix animation timing to 2s
    ## New Features
    - ✨ Added unified Control Panel with all system controls
    - 📊 Real-time block status visualization (15 blocks)
    - 🚨 Emergency Stop button
    - 🔄 Reconnect button when ESP32 offline
    - ⚙️ Quick access to Admin Panel
    ## Fixes
    - 🐛 Fixed animation timing: UP 5s→2s, LED fade 3s→2s
    - 🎯 Changed from hardcoded 5000ms to 2000ms in app/page.tsx
    ## UI Improvements
    - 🎨 Collapsible control panel (click to expand)
    - 💡 Live statistics: "X/15 blocks active"
    - 🟢 Visual block grid showing active/inactive blocks
    - 🎭 Smooth animations with Framer Motion
    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
    [main.cpp, rams_controller_v3.ino]
2026-02-19 Add .env.local with ESP32 credentials
    ESP32 IP: 192.168.110.65
2026-02-23 fix: video player stability — remove preload, fix decode errors, add volume slider
    - Remove use-video-preload.ts (was loading ALL videos into RAM needlessly)
    - Change preload="auto" to preload="metadata" (only read headers, not full file)
    - Fix decode errors: remove 5MB chunk cap in media:// protocol, let Chromium decide
    - Fix double autoplay race condition (single path via handleCanPlay)
    - Add retry limit (max 2) for decode errors to prevent infinite loop
    - Add visibility listener for kiosk mode recovery
    - Add always-visible volume slider control
    - Update .gitignore to exclude dist/, dist-new/, media/
    [main.cpp, protocol.h]
2026-02-23 fix: LED effects — restore brightness after OFF, remove color swap, add all effects to admin
    - Static and other effects now restore brightness to 200 when switching from OFF
    - Removed incorrect G↔B color swap — firmware handles byte order internally
    - Added CHASE, SPARKLE, FIRE, METEOR to admin panel LED controls (3x3 grid)
2026-02-26 feat: LED effects panel, ESP32 firmware overhaul, actuator control improvements
    - Add LED auto-cycle with rainbow color rotation and effect switching
    - Expand effect control panel with all firmware effects and speed control
    - Overhaul ESP32 firmware: add multiple LED effects, HTTP API improvements
    - Refactor esp32-client to use simplified IPC approach
    - Update admin modal with new LED controls
    - Fix screensaver and project sync minor issues
    [main.cpp]
2026-03-02 fix: remove duplicate hardware commands, simplify project sync
    - Remove hardwareService.selectProject/deselectProject from project-hub.tsx
    (was duplicating commands from page.tsx ProjectSync, causing immediate block lower on unmount)
    - Simplify activateProject: direct HTTP blockUp only, no LED manipulation
    (firmware handles LED zone highlighting via highlightBlock)
    - Fix deactivateProject: use direct HTTP instead of Electron IPC
    (IPC path didn't physically move blocks)
2026-03-02 feat: add video preload hook from main branch
    Merged unique feature from main branch:
    - lib/hooks/use-video-preload.ts - optimizes video loading
    This commit unifies the best features from both main and master branches.
    All other master features (LED control, HTTP API, LG TV integration) are preserved.
2026-03-02 feat(ui): Add all 8 LED effects and improve effect controls
    - Added missing LED effects to UI: Static (0), Pulse (1), Rainbow (2), Meteor (7)
    - Removed inefficient client-side rainbow color cycling (150ms setInterval)
    - Rainbow now uses firmware effect (ID 2) instead of client-side HSV cycling
    - Simplified auto-cycle logic in actuator control panel
    - Fixed React hydration warning in layout
    - Updated effect-control to show all 8 effects with responsive grid
    All 8 firmware effects now accessible from frontend:
    Static, Pulse, Rainbow, Chase, Sparkle, Wave, Fire, Meteor
2026-03-02 feat: Add ESP32 LED control, OTA support, and Next.js proxy
    ESP32 Firmware (main.cpp):
    - Fix LED color order: NEO_GRB → NEO_RGB (fix red/green swap)
    - Add OTA (Over-The-Air) firmware updates via WiFi
    - Hostname: RAMS-ESP32.local
    - Password: rams2024
    - Add block LED highlighting with instant color changes
    - UP state: Light blue RGB(80, 180, 255)
    - DOWN state: Orange RGB(255, 100, 0)
    - Add animation timer infrastructure for future smooth transitions
    - Update firmware to v2.1 with dual WiFi (AP+STA)
    Next.js Frontend:
    - Remove static export mode to enable server-side proxy
    - Add ESP32 API proxy: /esp32-api/* → http://192.168.110.65/api/*
    - Fix CORS issues when accessing ESP32 from b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
    [main.cpp]
2026-03-02 Fix ESP32 firmware: Pin config, LED highlight, OTA support
    Major improvements to ESP32 master firmware:
    🔧 Hardware Configuration:
    - Fix UART pin configuration (reverted to v3.2 correct pins)
    - Mega #1: GPIO 25 (TX) / GPIO 26 (RX)
    - Mega #2: GPIO 16 (TX) / GPIO 17 (RX)
    - Fix LED strip color order: NEO_GRB -> NEO_RGB
    💡 LED Highlight Improvements:
    - Remove UP block white highlight (was killing LED effects)
    - Add soft 30% orange blend for DOWN blocks
    - Smooth color blending: 70% current effect + 30% orange indicator
    - LED effects now visible throughout all block movements
    🌐 OTA (Over-The-Air) Update Support:
    - Add ArduinoOTA library for WiFi firmware updates
    - Auto-stop LED anima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
    [main.cpp]
2026-03-02 Fix LED color order: NEO_RGB -> NEO_GRB
    Critical fix for WS2812B LED strips:
    - Changed color order from NEO_RGB to NEO_GRB (line 63)
    - WS2812B strips use GRB color order by default
    - This was causing LEDs to not display correctly or freeze
    - Restore OTA configuration in platformio.ini
    This fixes the issue where LED effects were not responding.
    [main.cpp]
2026-03-04 Fix MEGA #2 actuator pin mapping and finalize v3.2
    Critical fixes for blocks 11, 12, 14, and 15:
    - Swap blocks 11 and 12 pin mapping (physical wiring was reversed)
    - Fix block 14: pins 42-45 (was incorrectly on 50-53)
    - Fix block 15 actuator 3: inverted UP/DOWN pins (51↑, 50↓)
    - Clarify that pins 52-53 are NOT used on MEGA #2
    - Add comprehensive PIN_MAPPING_REFERENCE.md documentation
    - Remove backup files
    All changes tested and verified on hardware.
    [ACTUATOR_CONFIG.h]
2026-03-04 ESP32 v3.3: Fixed LED mapping + OTA updates + Optimizations
    Major improvements to RAMS Controller firmware:
    ✅ Fixed LED Mapping:
    - Fixed block-to-LED coordinate mapping
    - Added BlockLEDCoords structure for caching
    - Coordinates calculated once in setup() instead of every frame
    - Eliminated ~100 lines of duplicated code
    ✅ Performance Optimizations:
    - Coordinate caching: ~2400 calculations/sec → 0 in runtime
    - Created applyFadeBrightnessToBlock() to avoid code duplication
    - Fade IN/OUT now use single unified function
    ✅ LED Effects Fixed:
    - Effects now work ALWAYS on active LEDs (via mask)
    - Fade IN/OUT only modulates brightness during up/down
    - Fade applied OVER effects, not replaci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
    [rams_controller_v3.ino]
2026-03-04 Fix: Update GPIO pins to correct mapping (32,22,18,21,13,27,4,14,5,2)
    ПРОБЛЕМА: LED не горели при поднятии блоков
    ПРИЧИНА: Неправильные GPIO пины в прошивке v3.3
    ИСПРАВЛЕНИЕ:
    - Обновлены GPIO пины на эталонную конфигурацию:
    Ray 1: GPIO 32 (было 21)
    Ray 2: GPIO 22 (осталось 22)
    Ray 3: GPIO 18 (было 23)
    Ray 4: GPIO 21 (было 15)
    Ray 5: GPIO 13 (осталось 13)
    Ray 6: GPIO 27 (осталось 27)
    Ray 7: GPIO 4 (было 32, перепаян с GPIO23)
    Ray 8: GPIO 14 (было 33)
    Inner: GPIO 5 (осталось 5)
    Outer: GPIO 2 (ост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
    [ACTUATOR_CONFIG.h, ZONE_CONFIG.h, ZONE_CONTROLLER.h, rams_controller_v3.ino]
2026-03-04 Fix: Outer circle mapping + fade OUT conflicts
    ПРОБЛЕМА 1: Большой круг не горит на блоках 3,4,6,10
    - Маппинг OUTER_START/OUTER_COUNT был в неправильном порядке
    ПРОБЛЕМА 2: При быстром переключении блоков LED не включаются
    - Fade OUT от предыдущего блока затемнял LED нового блока
    - Блоки пересекаются по кругам → конфликт
    ИСПРАВЛЕНИЯ:
    ✅ Переупорядочен OUTER_START: { 128, 0, 18, 38, 62, 84, 106, 0 }
    ✅ Переупорядочен OUTER_COUNT: { 22, 18, 20, 24, 22, 22, 22, 0 }
    ✅ П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
    [rams_controller_v3.ino]
2026-03-04 Fix: Smart fade conflicts + Always-on effects
    ПРОБЛЕМА 1: Fade OUT отменялся для ВСЕХ блоков
    - Fade должен работать для непересекающихся блоков
    ПРОБЛЕМА 2: Эффекты не работают без поднятых блоков
    - Маска пустая → LED не горят
    ✅ Fade OUT отменяется ТОЛЬКО для пересекающихся блоков
    - Проверка по сектору (same/adjacent)
    - Блоки 1-2, 3-4 и т.д. пересекаются
    - Блоки 1 и 5 НЕ пересекаются → fade работает
    ✅ Эффекты ра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
    [rams_controller_v3.ino]
